SEED-Team-512-NWTL/Temp-Logger/Team_512_Dev_Board_Rev_1_BOM.csv

Id | Designator | Footprint | Quantity | Designation | Supplier and ref
1 | C1, C6, C19, C24 | C_0201_0603Metric | 4 | 2.2u
2 | C2, C20 | C_0402_1005Metric_Pad0.74x0.62mm_HandSolder | 2 | 10u
3 | C3, C10, C11, C14, C21, C28, C29, C32 | C_0201_0603Metric | 8 | 100n
4 | C4, C22 | C_0201_0603Metric | 2 | 10n
5 | C5, C23 | C_0201_0603Metric | 2 | 2.2n
6 | C8, C26 | C_0201_0603Metric | 2 | 3.9p
7 | C9, C27 | C_0201_0603Metric | 2 | 1.5p
8 | C12, C30 | C_0201_0603Metric | 2 | 2.0p
9 | C15, C33 | C_0201_0603Metric | 2 | 0.3p
10 | C17, C18, C54, C55 | C_0603_1608Metric_Pad1.08x0.95mm_HandSolder | 4 | 1u
11 | C34, C40 | C_0402_1005Metric_Pad0.74x0.62mm_HandSolder | 2 | 12p
12 | C35, C36, C49, C50 | C_0603_1608Metric_Pad1.08x0.95mm_HandSolder | 4 | 4.7u
13 | C37, C38, C39, C42, C43, C44, C45, C46, C47, C48, C56 | C_0402_1005Metric_Pad0.74x0.62mm_HandSolder | 11 | 100n
14 | C41 | C_0603_1608Metric_Pad1.08x0.95mm_HandSolder | 1 | 3.3u
15 | C51 | C_0603_1608Metric_Pad1.08x0.95mm_HandSolder | 1 | 100n
16 | C52 | C_0603_1608Metric | 1 | 10p
17 | C53 | C_0603_1608Metric | 1 | 4.7u
18 | D1, D2, D3, D4, D5, D8, D9, D10 | LED_0805_2012Metric | 8 | LTST-C171GKT
19 | D6, D7 | D_SOD-123 | 2 | BZT52C5V1
20 | J1, J4, J7 | 1053091102 | 3 | 1053091102
21 | J2 | PinHeader_1x03_P2.54mm_Vertical | 1 | 2.54mm
22 | J3 | USB_C_Receptacle_GCT_USB4105-xx-A_16P_TopMnt_Horizontal | 1 | USB_C_Receptacle_USB2.0_14P
23 | J5, J6 | Banana_Cliff_FCR7350B_S16N-PC_Horizontal | 2 | FCR7350B
24 | J8, J9 | MM8130-2600RA2 | 2 | MM8130-2600RA2
25 | J10, J11, J12 | PinHeader_1x02_P1.00mm_Vertical | 3 | 1mm
26 | L1, L5 | L_0603_1608Metric | 2 | 4.7u
27 | L2, L6 | L_0201_0603Metric | 2 | 2.7n
28 | L3, L4, L7, L8 | L_0201_0603Metric | 4 | 3.5n
29 | L9 | L_1008_2520Metric_Pad1.43x2.20mm_HandSolder | 1 | 1u
30 | Q1, Q2, Q3, Q4, Q7, Q8 | SMMBT3904LT1G | 6 | SMMBT3904LT1G
31 | Q5, Q6 | SOT-23 | 2 | AO3401A
32 | R1, R2, R3, R4, R10, R11, R12, R13, R16, R17, R18, R19, R36, R37 | R_0603_1608Metric_Pad0.98x0.95mm_HandSolder | 14 | 0
33 | R5, R14 | R_0201_0603Metric | 2 | 0
34 | R6 | R_1206_3216Metric_Pad1.30x1.75mm_HandSolder | 1 | 100m
35 | R7, R15 | R_0201_0603Metric | 2 | 1k
36 | R20 | R_0402_1005Metric_Pad0.72x0.64mm_HandSolder | 1 | 12k
37 | R21, R23, R24, R25, R26 | R_0402_1005Metric_Pad0.72x0.64mm_HandSolder | 5 | 1k
38 | R22, R27, R28, R29 | R_0402_1005Metric_Pad0.72x0.64mm_HandSolder | 4 | 100
39 | R30, R31 | R_0603_1608Metric_Pad0.98x0.95mm_HandSolder | 2 | 5.1k
40 | R32, R41, R42, R43 | R_0603_1608Metric_Pad0.98x0.95mm_HandSolder | 4 | 100
41 | R33 | R_0603_1608Metric_Pad0.98x0.95mm_HandSolder | 1 | 100k
42 | R34, R35, R38 | R_0603_1608Metric_Pad0.98x0.95mm_HandSolder | 3 | 22k
43 | R39, R40 | R_0402_1005Metric_Pad0.72x0.64mm_HandSolder | 2 | 4.7k
44 | SW1, SW2 | SW_Push_1P1T_NO_CK_KMR2 | 2 | KMR211G LFS
45 | TP1, TP2, TP3, TP4, TP5, TP6, TP7, TP9, TP10, TP11, TP12, TP13, TP14, TP15, TP16, TP18, TP19, TP20, TP21, TP22 | TestPoint_Pad_D1.0mm | 20 | 1.0mm
46 | U1, U2 | NRF54L15-QFAA-R | 2 | nRF54L15-QFAA-R
47 | U3 | WSON-6-1EP_2x2mm_P0.65mm_EP1x1.6mm | 1 | TMP117xxDRV
48 | U6 | SOT-23-6 | 1 | USBLC6-2SC6
49 | U7 | LQFP-64_10x10mm_P0.5mm | 1 | FT2232HL
50 | U8 | SOT-563 | 1 | TPS62A01ADRL
51 | Y1, Y2 | ECS-320-8-37B-CKY-TR | 2 | ECS-320-8-37B-CKY-TR
52 | Y3 | ABM8AIG-12.000MHZ-12-2Z-T3 | 1 | ABM8AIG-12.000MHZ-12-2Z-T3
53 | Y4, Y5 | SC-20S,32.768kHz,20PPM,9pF | 2 | SC-20S,32.768kHz,20PPM,9pF
