SEED-Team-512-NWTL/Temp-Logger/production/NWTL_Dev_Board_Rev_1_bom.csv

Designator | Footprint | Quantity | Value | LCSC Part # | Do Not Populate
C1, C19, C24, C6 | 0201 | 4 | 2.2u | C76933
C10, C11, C14, C21, C28, C29, C3, C32 | 0201 | 8 | 100n | C284992
C12, C30 | 0201 | 2 | 2.0p | C668326
C15, C33 | 0201 | 2 | 0.3p | C76927
C17, C18, C54, C55 | 0603 | 4 | 1u |  | TRUE
C2, C20 | 0402 | 2 | 10u | C15525
C22, C4 | 0201 | 2 | 10n | C309453
C23, C5 | 0201 | 2 | 2.2n | C526947
C26, C8 | 0201 | 2 | 3.9p | C76926
C27, C9 | 0201 | 2 | 1.5p | C435397
C34, C40 | 0402 | 2 | 12p | C85875
C35, C36, C49, C50, C53 | 0603 | 5 | 4.7u | C1705
C37, C38, C39, C42, C43, C44, C45, C46, C47, C48, C56 | 0402 | 11 | 100n | C1525
C41 | 0603 | 1 | 3.3u | C51412
C51 | 0603 | 1 | 100n | C1590
C52 | 0603 | 1 | 10p |  | TRUE
D1, D10, D2, D3, D4, D5, D8, D9 | 0805 | 8 | LTST-C171GKT | C913075
D6, D7 | D_SOD-123 | 2 | BZT52C5V1 | C2117
J1, J4, J7 | 1053091102 | 3 | 1053091102 | C2938824
J10, J11, J12 | PinHeader_1x02_P1.00mm_Vertical | 3 | 1mm |  | TRUE
J13 | PinHeader_1x09_P2.54mm_Vertical | 1 | 2.54mm |  | TRUE
J2 | PinHeader_1x03_P2.54mm_Vertical | 1 | 2.54mm |  | TRUE
J3 | USB_C_Receptacle_GCT_USB4105-xx-A_16P_TopMnt_Horizontal | 1 | USB_C_Receptacle_USB2.0_14P | C3020560
J5, J6 | Banana_Cliff_FCR7350B_S16N-PC_Horizontal | 2 | FCR7350B |  | TRUE
J8, J9 | MM8130-2600RA2 | 2 | MM8130-2600RA2 | C167503
L1, L5 | 0603 | 2 | 4.7u | C76799
L2, L6 | 0201 | 2 | 2.7n | C7216765
L3, L4, L7, L8 | 0201 | 4 | 3.5n | C3911055
L9 | 1008 | 1 | 1u | C435392
Q1, Q2, Q3, Q4, Q7, Q8 | SMMBT3904LT1G | 6 | SMMBT3904LT1G | C84555
Q5, Q6 | SOT-23 | 2 | AO3401A | C15127
R1, R10, R11, R12, R13, R16, R17, R18, R19, R2, R3, R36, R37, R4 | 0603 | 14 | 0 | C177335
R14, R5 | 0201 | 2 | 0 | C100147
R15, R7 | 0201 | 2 | 1k | C131396
R20 | 0402 | 1 | 12k | C114760
R21, R23, R24, R25, R26 | 0402 | 5 | 1k | C71623
R22, R27, R28, R29, R42, R43 | 0402 | 6 | 100 | C82865
R30, R31 | 0603 | 2 | 5.1k | C14677
R32, R41 | 0603 | 2 | 100 | C105588
R33 | 0603 | 1 | 100k | C14675
R34, R35, R38 | 0603 | 3 | 22k | C114065
R39, R40, R44, R45 | 0402 | 4 | 4.7k | C105870
R6 | 1206 | 1 | 330m | C2932844
SW1, SW2 | SW_Push_1P1T_NO_CK_KMR2 | 2 | KMR211G LFS | C221675
U1, U2 | NRF54L15-QFAA-R | 2 | nRF54L15-QFAA-R | C42458750
U3 | WSON-6-1EP_2x2mm_P0.65mm_EP1x1.6mm | 1 | TMP117AIDRVR | C699536
U6 | SOT-23-6 | 1 | USBLC6-2SC6 | C7519
U7 | LQFP-64_10x10mm_P0.5mm | 1 | FT2232HL | C27882
U8 | SOT-563 | 1 | TPS62A01ADRL | C5181455
Y1, Y2 | ECS-320-8-37B-CKY-TR | 2 | ECS-320-8-37B-CKY-TR | C2636238
Y3 | ABM8AIG-12.000MHZ-12-2Z-T3 | 1 | ABM8AIG-12.000MHZ-12-2Z-T3 | C1985448
Y4, Y5 | SC-20S,32.768kHz,20PPM,9pF | 2 | SC-20S,32.768kHz,20PPM,9pF | C97603
