SEED-Team-512-NWTL/Temp-Logger/Temp-Logger.kicad_pcb

## KiCad design Temp-Logger.kicad_pcb (2026-11-11)

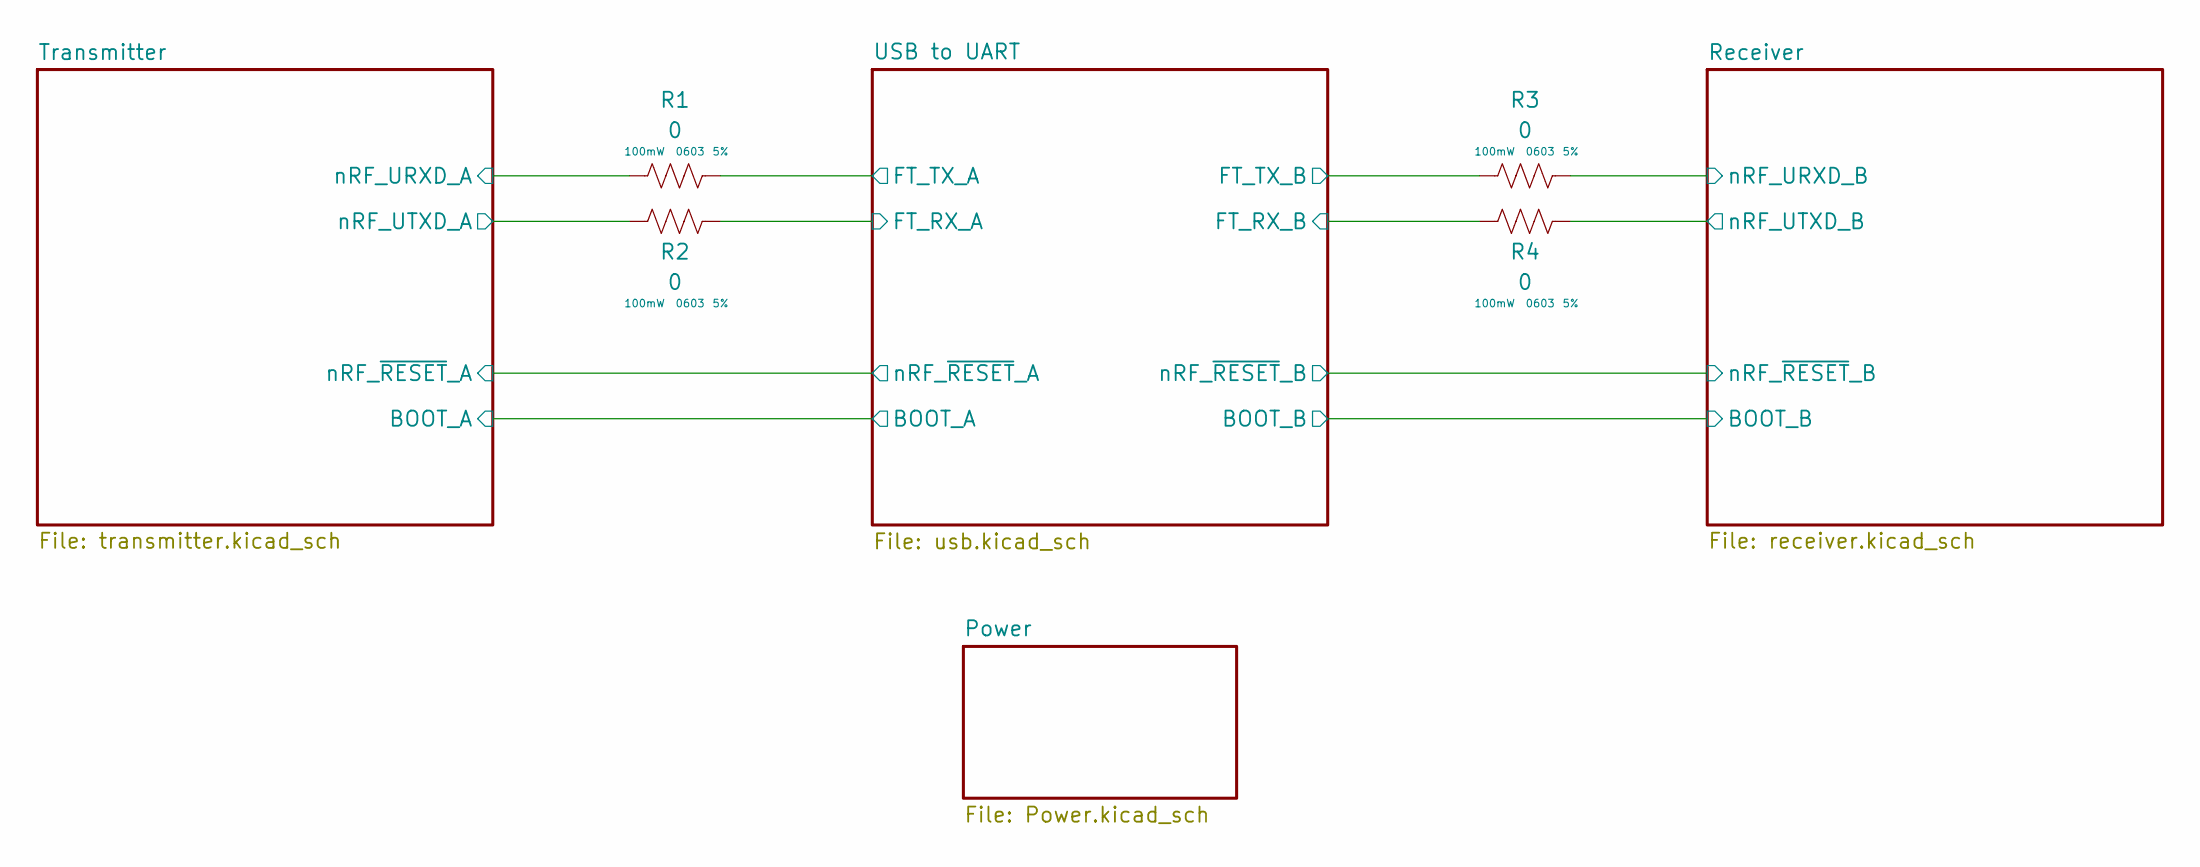
[picture p1: schematic Temp-Logger.kicad_sch, Temperature Logger]

Parts:
R1, R2, R3, R4: 0; R_0603_1608Metric_Pad0.98x0.95mm_HandSolder; Tolerance 5%; LCSC C177335

Connections:
/Receiver/nRF_URXD_B: R3.2; also elsewhere on the board
/Receiver/nRF_UTXD_B: R4.2; also elsewhere on the board
/Transmitter/nRF_URXD_A: R1.1; also elsewhere on the board
/Transmitter/nRF_UTXD_A: R2.1; also elsewhere on the board
/USB to UART/FT_RX_A: R2.2; also elsewhere on the board
/USB to UART/FT_RX_B: R4.1; also elsewhere on the board
/USB to UART/FT_TX_A: R1.2; also elsewhere on the board
/USB to UART/FT_TX_B: R3.1; also elsewhere on the board

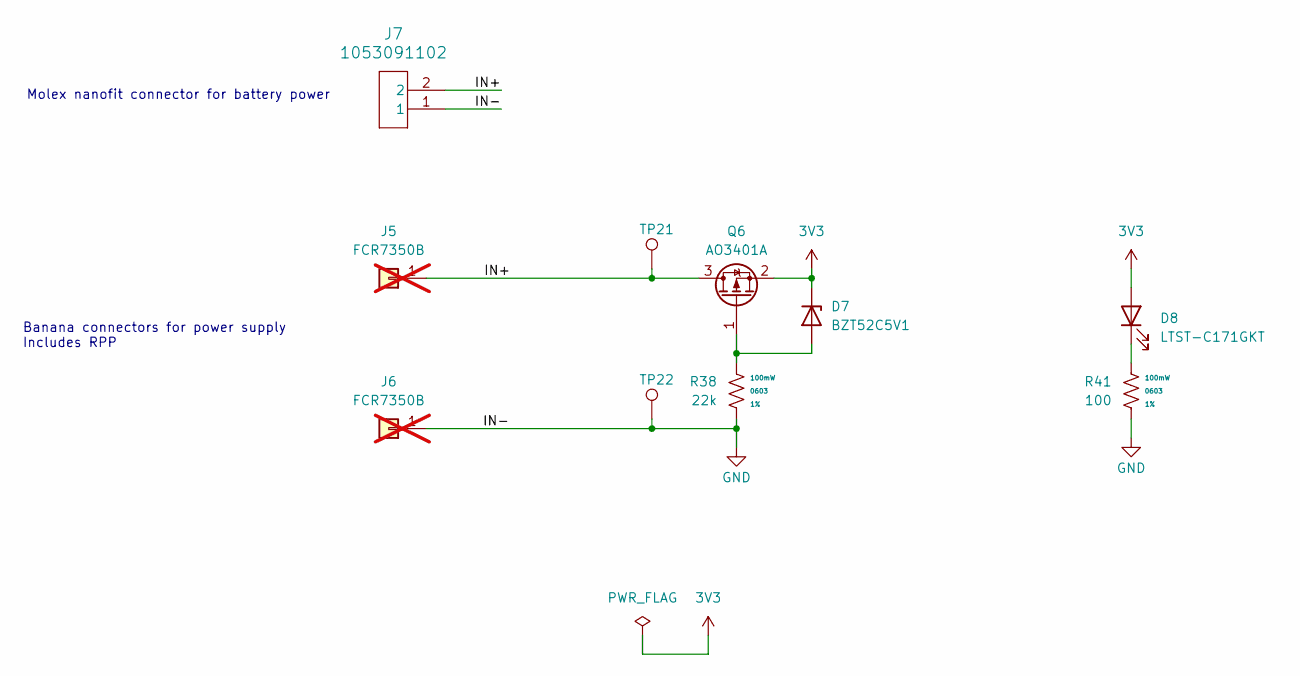
[picture p2: schematic Power.kicad_sch, Temperature Logger]

Parts:
D7: BZT52C5V1; D_SOD-123; LCSC C2117
D8: LTST-C171GKT; LED_0805_2012Metric; LCSC C913075
J5, J6: FCR7350B; Banana_Cliff_FCR7350B_S16N-PC_Horizontal; not fitted
J7: 1053091102; LCSC C2938824
Q6: AO3401A; SOT-23; LCSC C15127
R38: 22k; R_0603_1608Metric_Pad0.98x0.95mm_HandSolder; Tolerance 1%; LCSC C114065
R41: 100; R_0603_1608Metric_Pad0.98x0.95mm_HandSolder; Tolerance 1%; LCSC C105588
TP21, TP22: 1.0mm; TestPoint_Pad_D1.0mm

Connections:
3V3: D7.1 (K), D8.2 (A), Q6.2 (S); also elsewhere on the board
/Power/IN+: J5.1 (Pin_1_1), J7.2, Q6.3 (D), TP21.1 (1_1)
GND: J6.1 (Pin_1_1), J7.1, R38.1, R41.1, TP22.1 (1_1); also elsewhere on the board
unnamed: D7.2 (A), Q6.1 (G), R38.2
unnamed: D8.1 (K), R41.2

Notes on the sheet:
Banana connectors for power supply Includes RPP
Molex nanofit connector for battery power

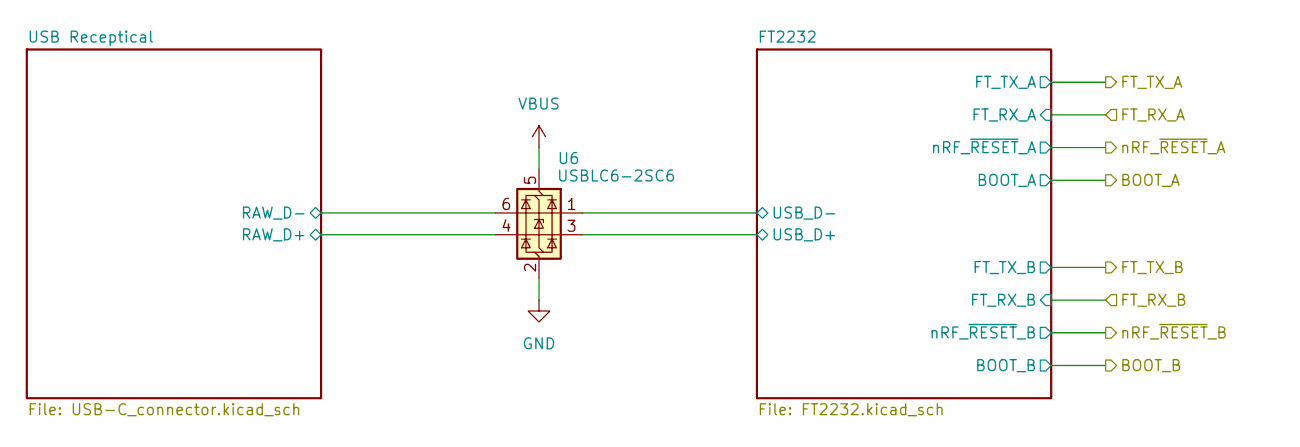
[picture p3: schematic usb.kicad_sch, Temperature Logger]

Parts:
U6: USBLC6-2SC6; SOT-23-6; LCSC C7519

Connections:
/USB to UART/FT2232/USB_D+: U6.3 (I/O2); also elsewhere on the board
/USB to UART/FT2232/USB_D-: U6.1 (I/O1); also elsewhere on the board
/USB to UART/USB Receptical/RAW_D+: U6.4 (I/O2); also elsewhere on the board
/USB to UART/USB Receptical/RAW_D-: U6.6 (I/O1); also elsewhere on the board
GND: U6.2 (GND); also elsewhere on the board
VBUS: U6.5 (VBUS); also elsewhere on the board

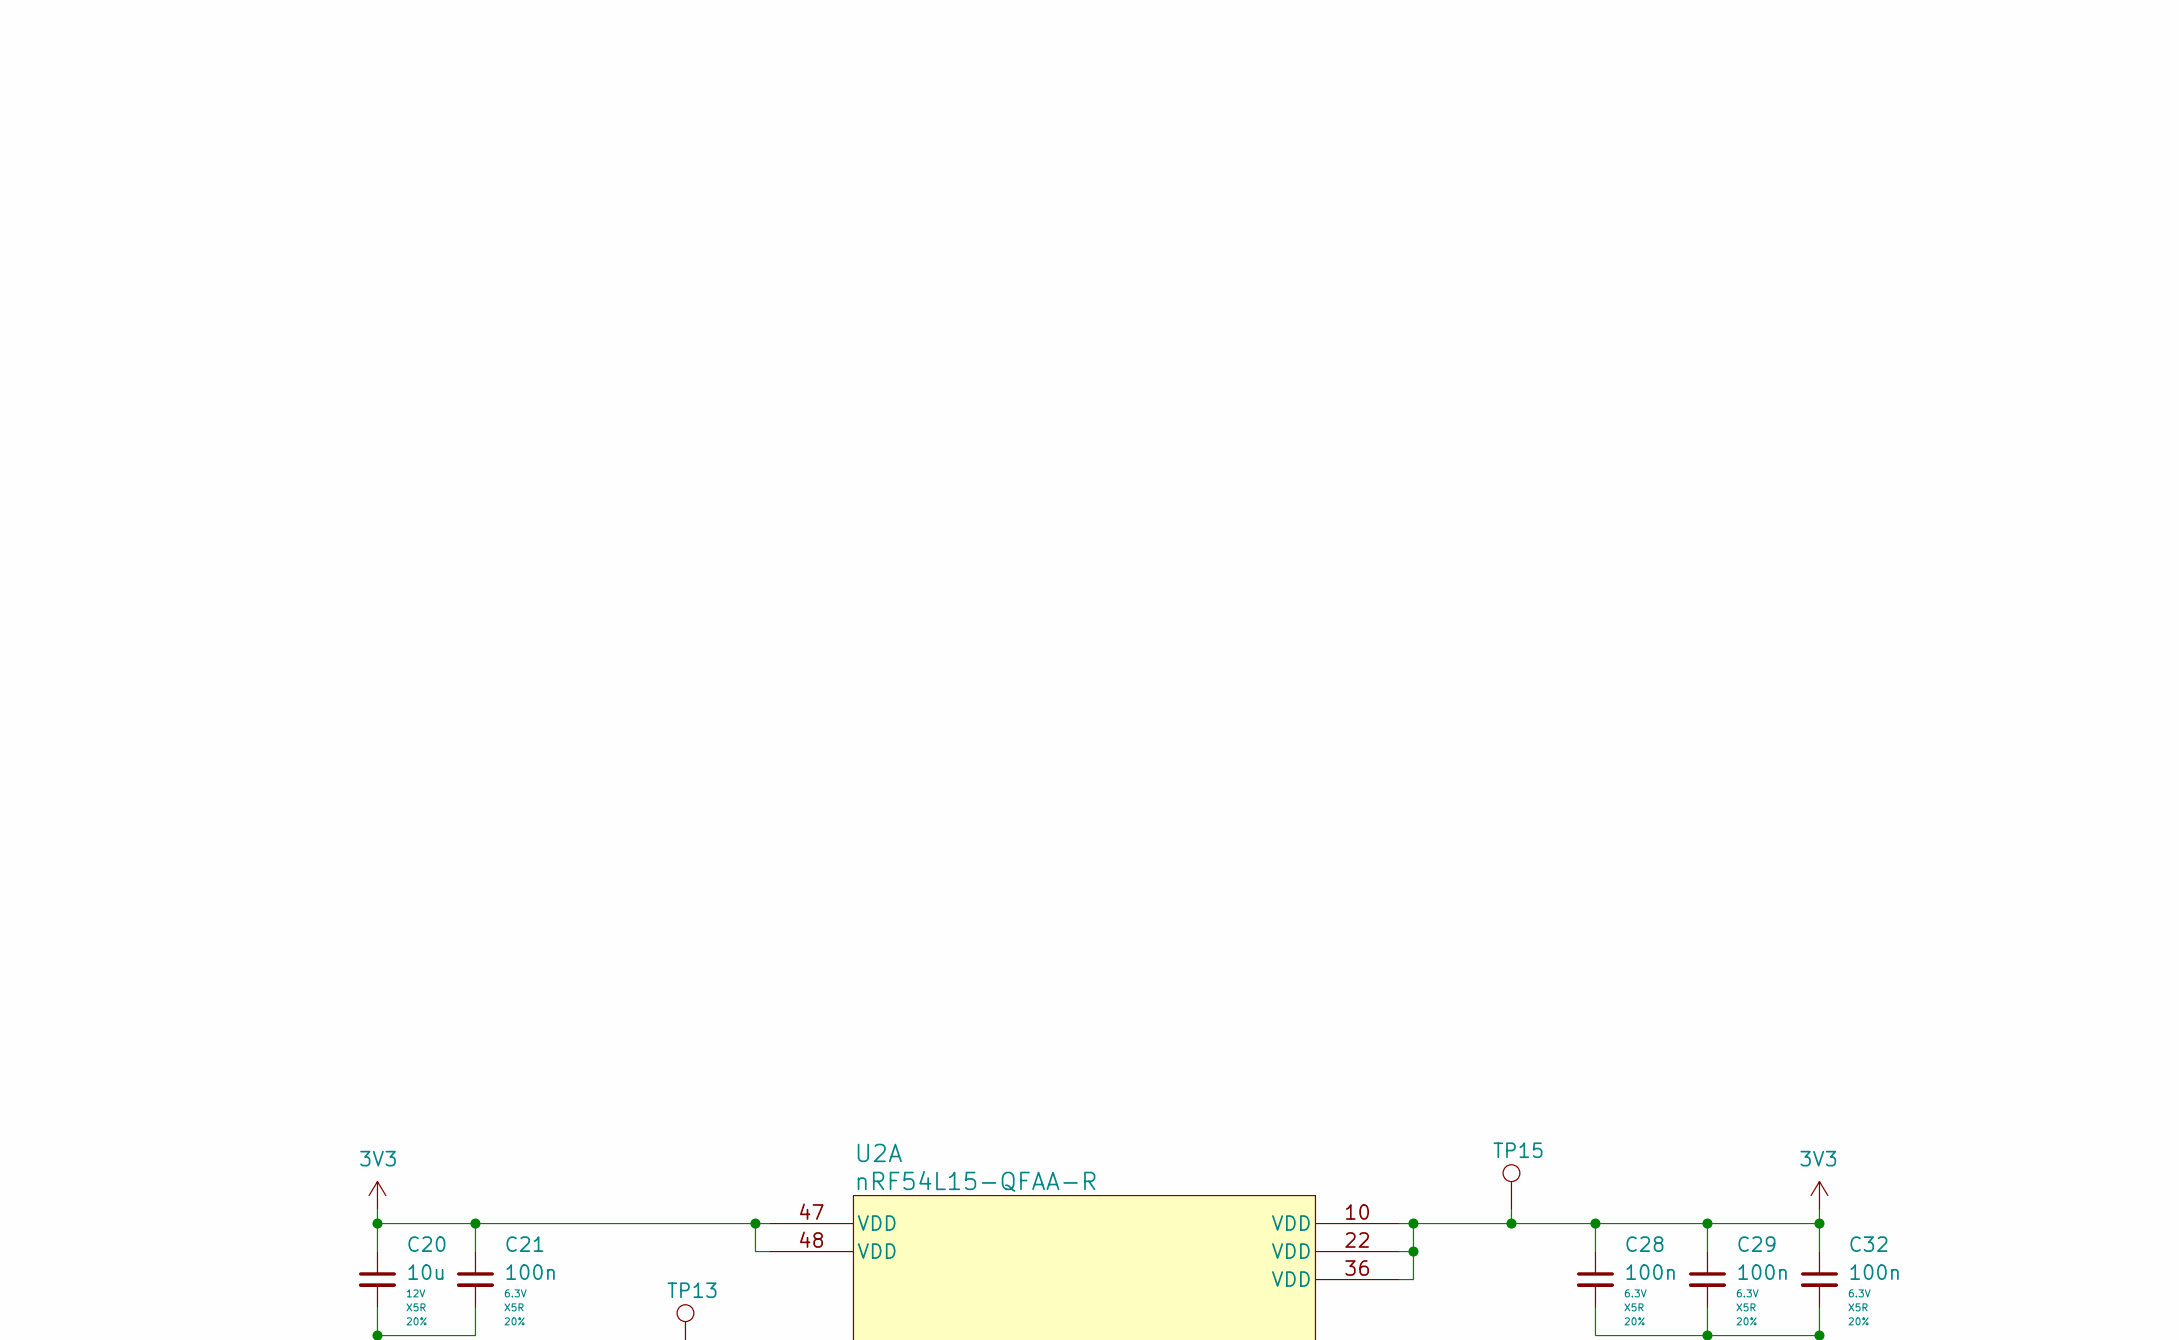
[picture p4: schematic rx_microcontroller.kicad_sch, Temperature Logger, part in row 1, column 1]

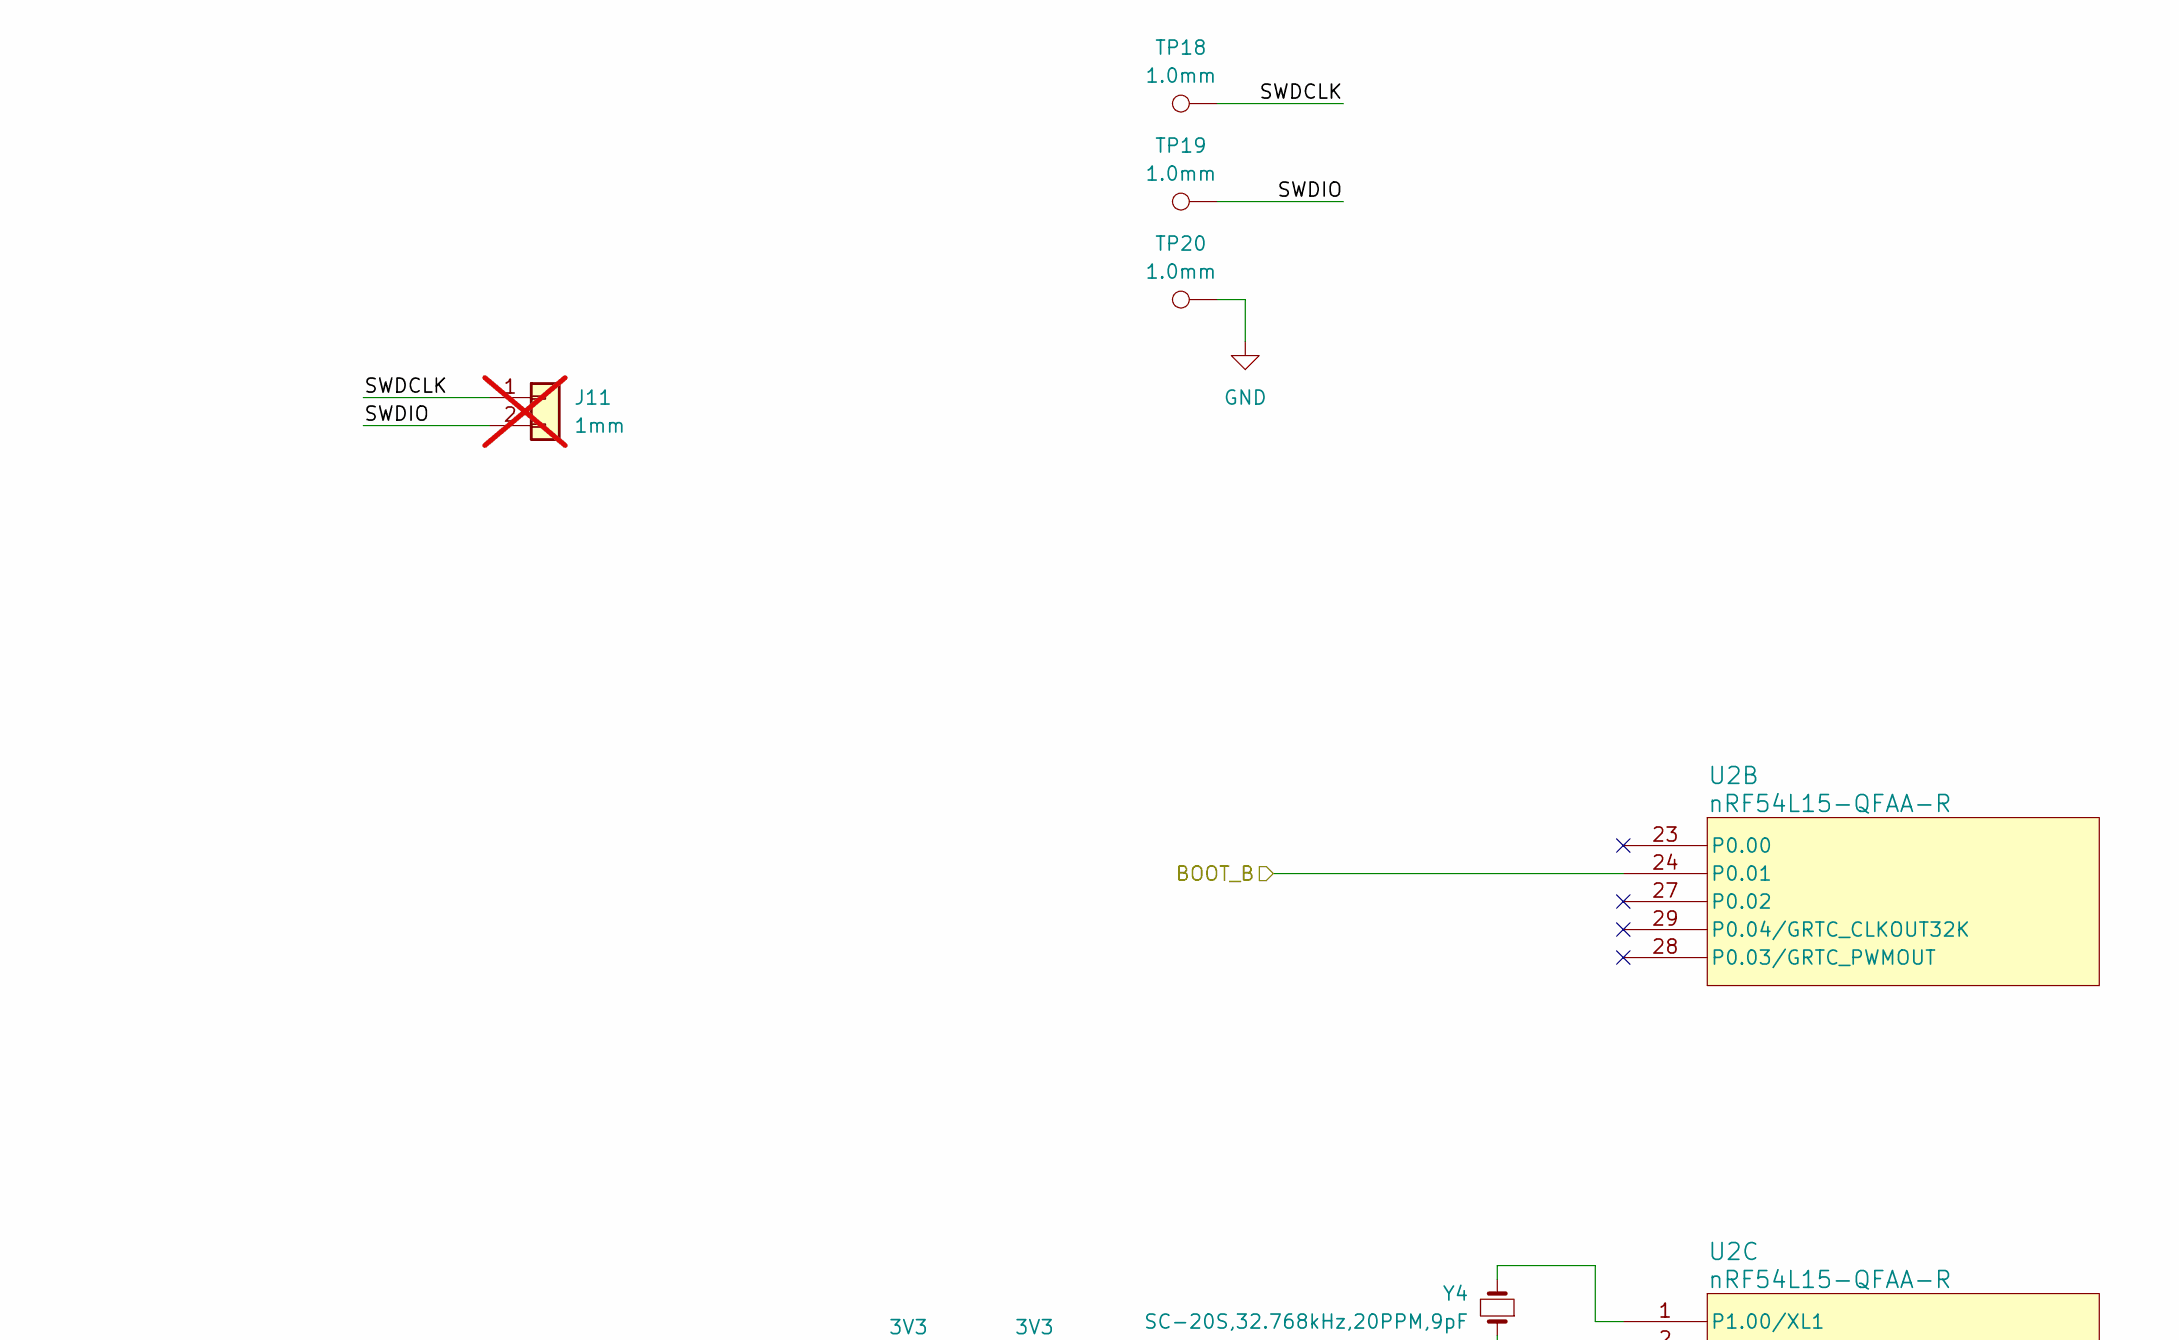
[picture p5: schematic rx_microcontroller.kicad_sch, Temperature Logger, part in row 1, column 2]

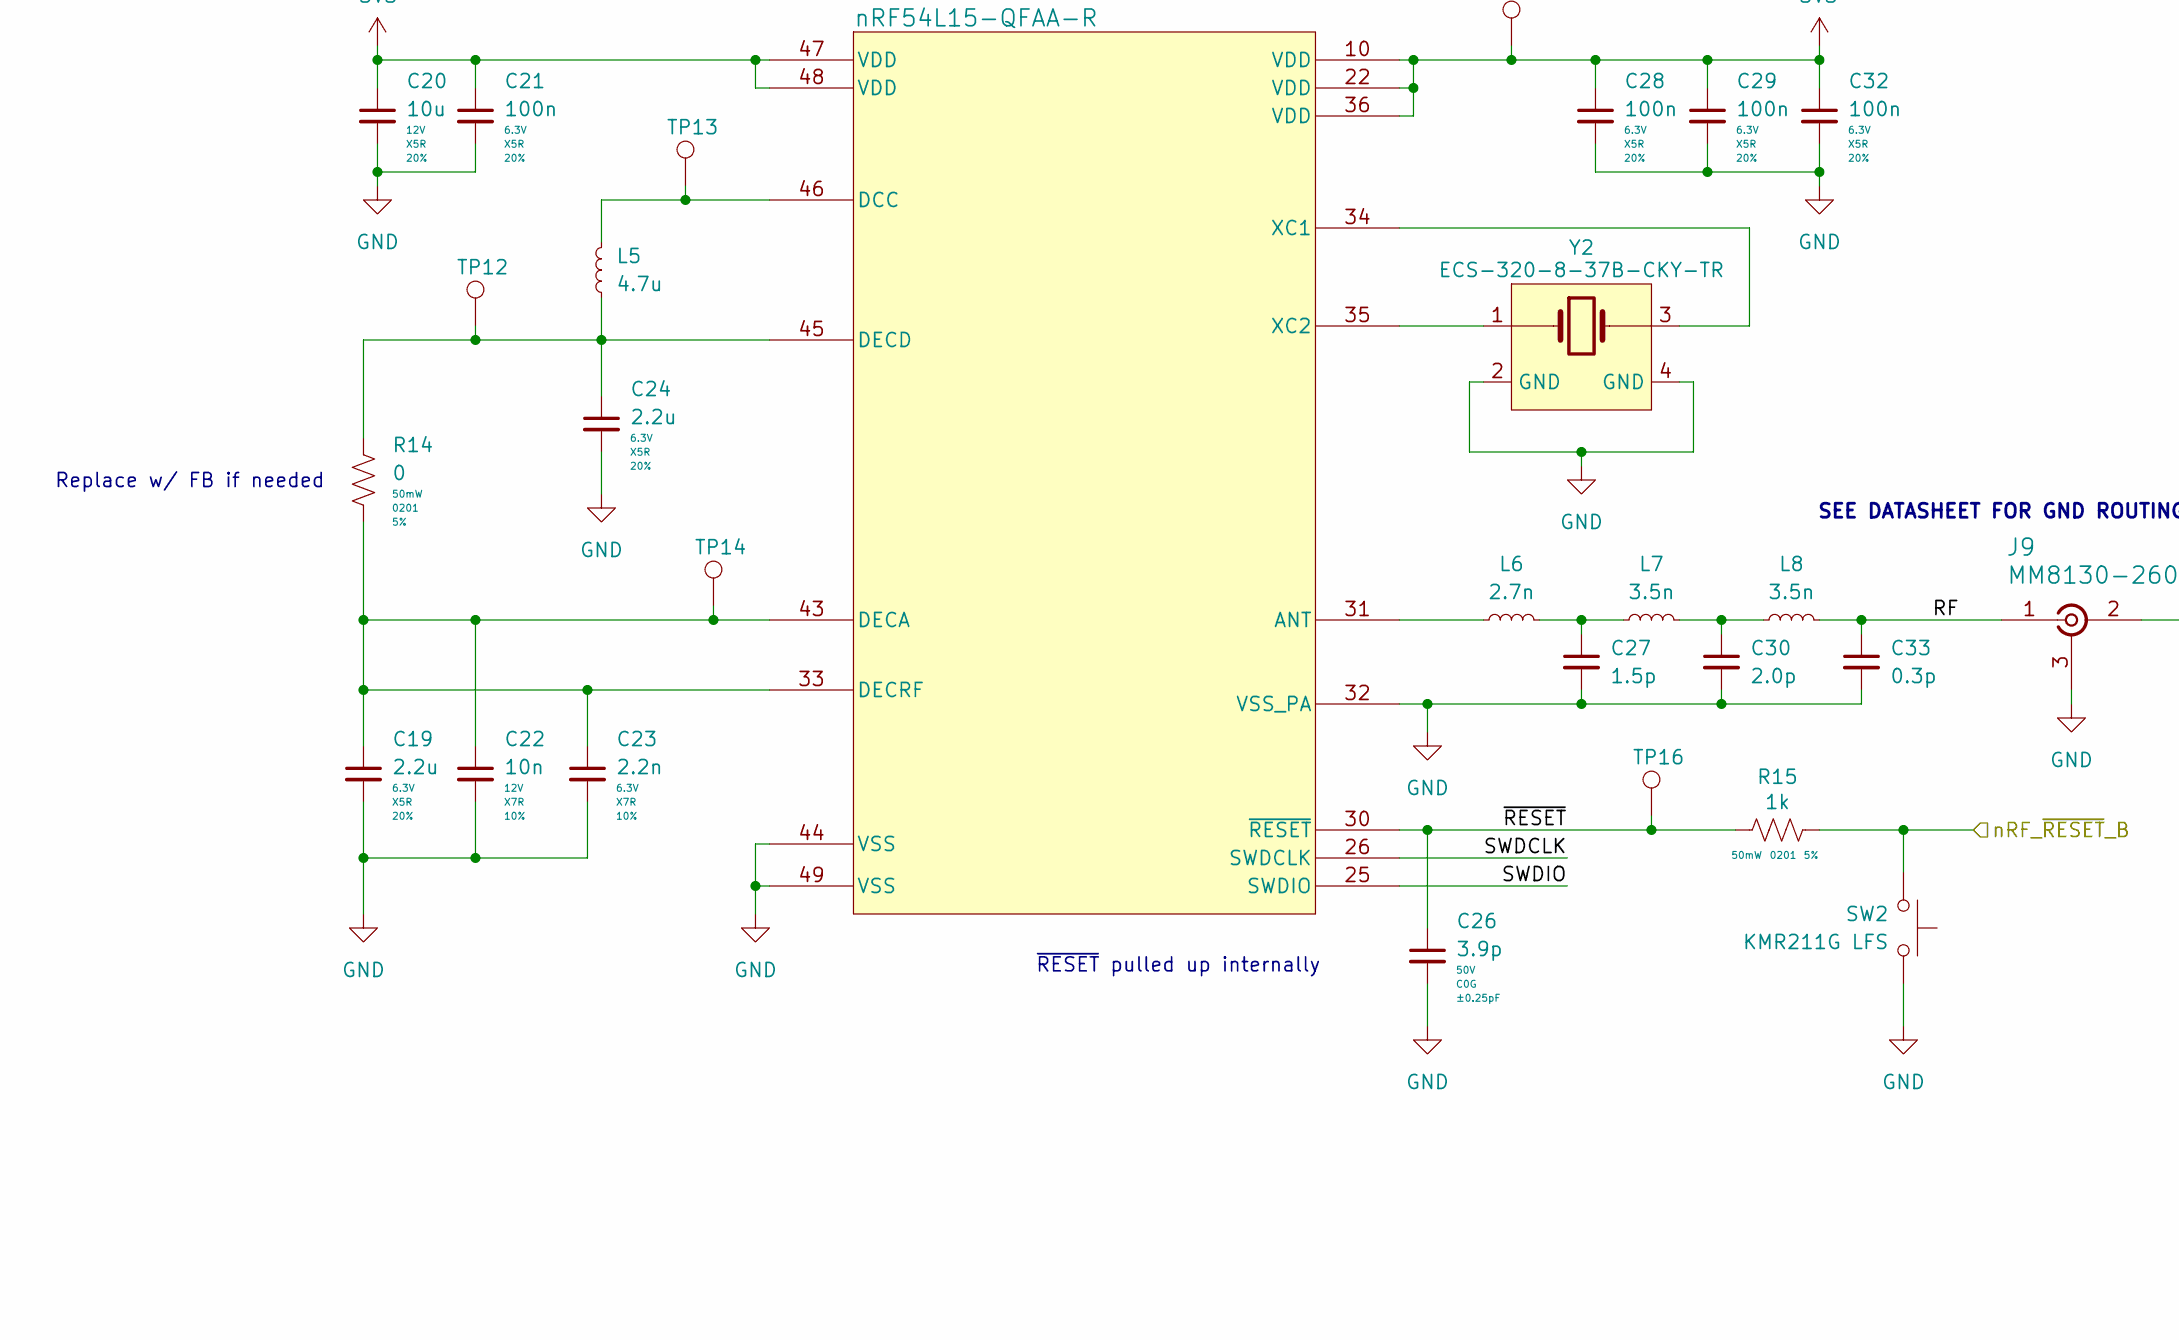
[picture p6: schematic rx_microcontroller.kicad_sch, Temperature Logger, part in row 2, column 1]

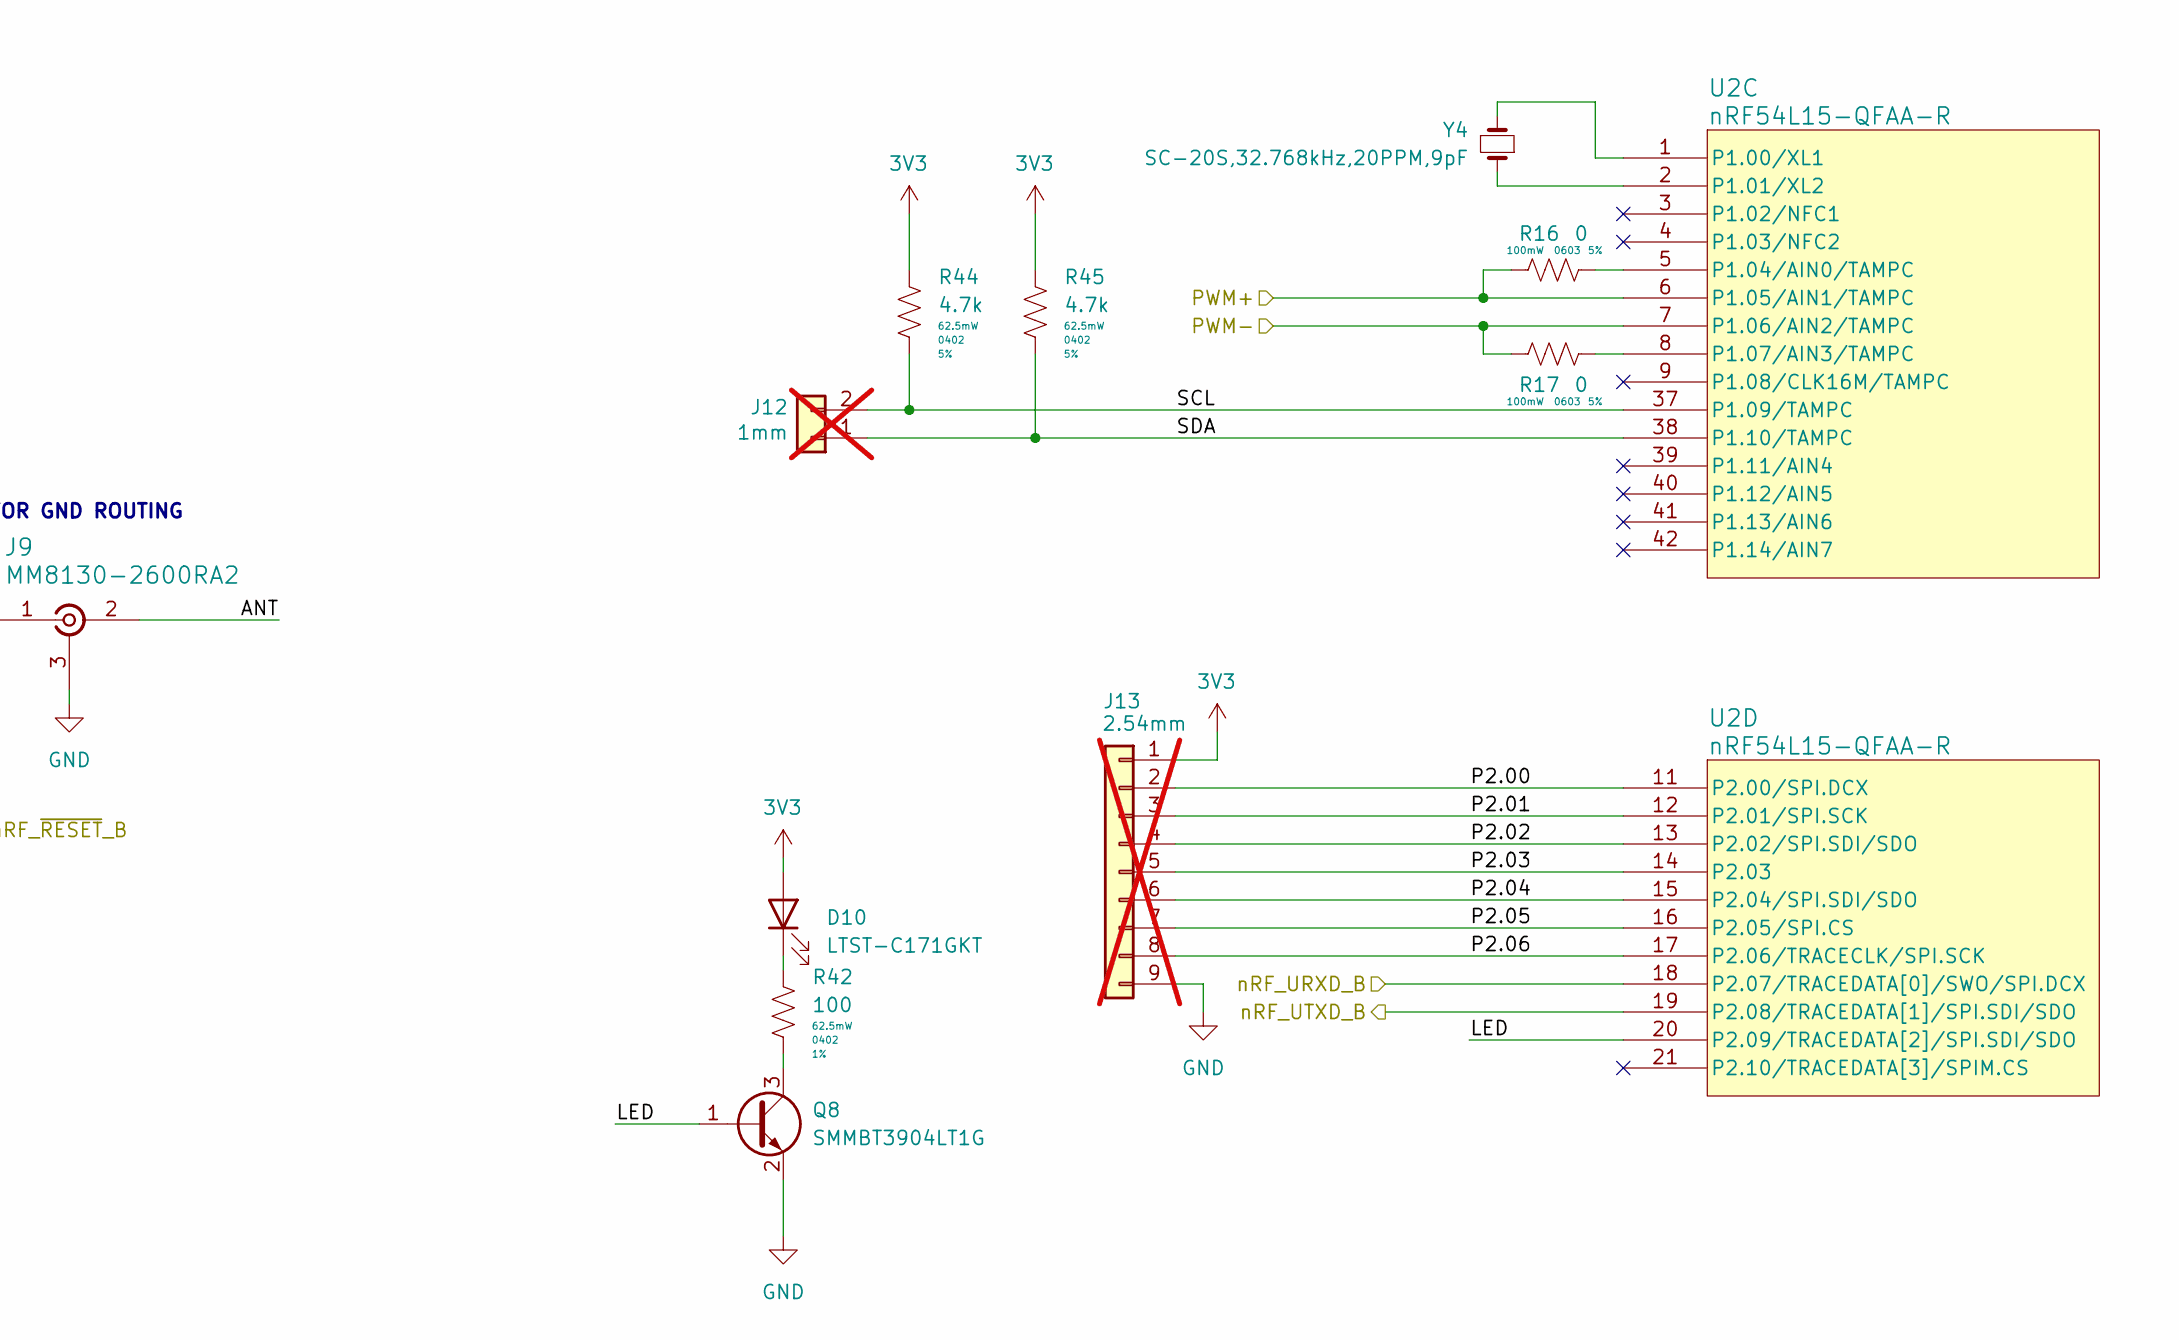
[picture p7: schematic rx_microcontroller.kicad_sch, Temperature Logger, part in row 2, column 2]

Parts:
C19, C24: 2.2u; C_0201_0603Metric; Voltage Rating 6.3V; Tolerance 20%; LCSC C76933
C20: 10u; C_0402_1005Metric_Pad0.74x0.62mm_HandSolder; Voltage Rating 12V; Tolerance 20%; LCSC C15525
C21, C28, C29, C32: 100n; C_0201_0603Metric; Voltage Rating 6.3V; Tolerance 20%; LCSC C284992
C22: 10n; C_0201_0603Metric; Voltage Rating 12V; Tolerance 10%; LCSC C309453
C23: 2.2n; C_0201_0603Metric; Voltage Rating 6.3V; Tolerance 10%; LCSC C526947
C26: 3.9p; C_0201_0603Metric; Voltage Rating 50V; Tolerance ±0.25pF; LCSC C76926
C27: 1.5p; C_0201_0603Metric; Part Number GJM0335C1E1R5WB01; LCSC C435397
C30: 2.0p; C_0201_0603Metric; Part Number GJM0335C1E2R0WB01; LCSC C668326
C33: 0.3p; C_0201_0603Metric; LCSC C76927
D10: LTST-C171GKT; LED_0805_2012Metric; LCSC C913075
J9: MM8130-2600RA2; LCSC C167503
J11, J12: 1mm; PinHeader_1x02_P1.00mm_Vertical; not fitted
J13: 2.54mm; PinHeader_1x09_P2.54mm_Vertical; not fitted
L5: 4.7u; L_0603_1608Metric; LCSC C76799
L6: 2.7n; L_0201_0603Metric; Part Number GJM0335C1E1R5WB01; LCSC C7216765
L7, L8: 3.5n; L_0201_0603Metric; Part Number LQP03HQ3N5B02; LCSC C3911055
Q8: SMMBT3904LT1G; LCSC C84555
R14: 0; R_0201_0603Metric; Tolerance 5%; LCSC C100147
R15: 1k; R_0201_0603Metric; Tolerance 5%; LCSC C131396
R16, R17: 0; R_0603_1608Metric_Pad0.98x0.95mm_HandSolder; Tolerance 5%; LCSC C177335
R42: 100; R_0402_1005Metric_Pad0.72x0.64mm_HandSolder; Tolerance 1%; LCSC C82865
R44, R45: 4.7k; R_0402_1005Metric_Pad0.72x0.64mm_HandSolder; Tolerance 5%; LCSC C105870
SW2: KMR211G LFS; SW_Push_1P1T_NO_CK_KMR2; LCSC C221675
TP12, TP13, TP14, TP15, TP16, TP18, TP19, TP20: 1.0mm; TestPoint_Pad_D1.0mm
U2: nRF54L15-QFAA-R; NRF54L15-QFAA-R
Y2: ECS-320-8-37B-CKY-TR; LCSC C2636238
Y4: SC-20S,32.768kHz,20PPM,9pF; LCSC C97603

Connections:
3V3: C20.1, C21.1, C28.1, C29.1, C32.1, D10.2 (A), J13.1, R44.1, R45.1, TP15.1 (1_1), U2.10 (VDD), U2.22 (VDD), U2.36 (VDD), U2.47 (VDD), U2.48 (VDD); also elsewhere on the board
/Receiver/BOOT_B: U2.24 (P0.01); also elsewhere on the board
/Receiver/Piezoelectric/PWM+: R16.1, U2.6 (P1.05/AIN1/TAMPC); also elsewhere on the board
/Receiver/Piezoelectric/PWM-: R17.1, U2.7 (P1.06/AIN2/TAMPC); also elsewhere on the board
/Receiver/RX Microcontroller/ANT: J9.2 (OUT)
/Receiver/RX Microcontroller/LED: Q8.1 (B), U2.20 (P2.09/TRACEDATA[2]/SPI.SDI/SDO)
/Receiver/RX Microcontroller/P2.00: J13.2, U2.11 (P2.00/SPI.DCX)
/Receiver/RX Microcontroller/P2.01: J13.3, U2.12 (P2.01/SPI.SCK)
/Receiver/RX Microcontroller/P2.02: J13.4, U2.13 (P2.02/SPI.SDI/SDO)
/Receiver/RX Microcontroller/P2.03: J13.5, U2.14 (P2.03)
/Receiver/RX Microcontroller/P2.04: J13.6, U2.15 (P2.04/SPI.SDI/SDO)
/Receiver/RX Microcontroller/P2.05: J13.7, U2.16 (P2.05/SPI.CS)
/Receiver/RX Microcontroller/P2.06: J13.8, U2.17 (P2.06/TRACECLK/SPI.SCK)
/Receiver/RX Microcontroller/RF: C33.1, J9.1 (IN), L8.2
/Receiver/RX Microcontroller/SCL: J12.2, R44.2, U2.37 (P1.09/TAMPC)
/Receiver/RX Microcontroller/SDA: J12.1, R45.2, U2.38 (P1.10/TAMPC)
/Receiver/RX Microcontroller/SWDCLK: J11.1, TP18.1 (1_1), U2.26 (SWDCLK)
/Receiver/RX Microcontroller/SWDIO: J11.2, TP19.1 (1_1), U2.25 (SWDIO)
/Receiver/RX Microcontroller/~RESET: C26.1, R15.1, TP16.1 (1_1), U2.30 (~RESET)
/Receiver/nRF_URXD_B: U2.18 (P2.07/TRACEDATA[0]/SWO/SPI.DCX); also elsewhere on the board
/Receiver/nRF_UTXD_B: U2.19 (P2.08/TRACEDATA[1]/SPI.SDI/SDO); also elsewhere on the board
/Receiver/nRF_~RESET_B: R15.2, SW2.2; also elsewhere on the board
GND: C19.2, C20.2, C21.2, C22.2, C23.2, C24.2, C26.2, C27.2, C28.2, C29.2, C30.2, C32.2, C33.2, J9.3 (GND), J9.4 (GND), J9.5 (GND), J9.6 (GND), J13.9, Q8.2 (E), SW2.1, TP20.1 (1_1), U2.32 (VSS_PA), U2.44 (VSS), U2.49 (VSS), Y2.2 (GND), Y2.4 (GND); also elsewhere on the board
unnamed: C27.1, L6.2, L7.1
unnamed: C30.1, L7.2, L8.1
unnamed: D10.1 (K), R42.1
unnamed: Q8.3 (C), R42.2
unnamed: L6.1, U2.31 (ANT)
unnamed: L5.2, TP13.1 (1_1), U2.46 (DCC)
unnamed: C19.1, C22.1, C23.1, R14.1, TP14.1 (1_1), U2.33 (DECRF), U2.43 (DECA)
unnamed: C24.1, L5.1, R14.2, TP12.1 (1_1), U2.45 (DECD)
unnamed: U2.34 (XC1), Y2.3
unnamed: U2.35 (XC2), Y2.1
unnamed: U2.1 (P1.00/XL1), Y4.2
unnamed: U2.2 (P1.01/XL2), Y4.1
unnamed: R16.2, U2.5 (P1.04/AIN0/TAMPC)
unnamed: R17.2, U2.8 (P1.07/AIN3/TAMPC)

Notes on the sheet:
~{RESET} pulled up internally
Replace w/ FB if needed
SEE DATASHEET FOR GND ROUTING

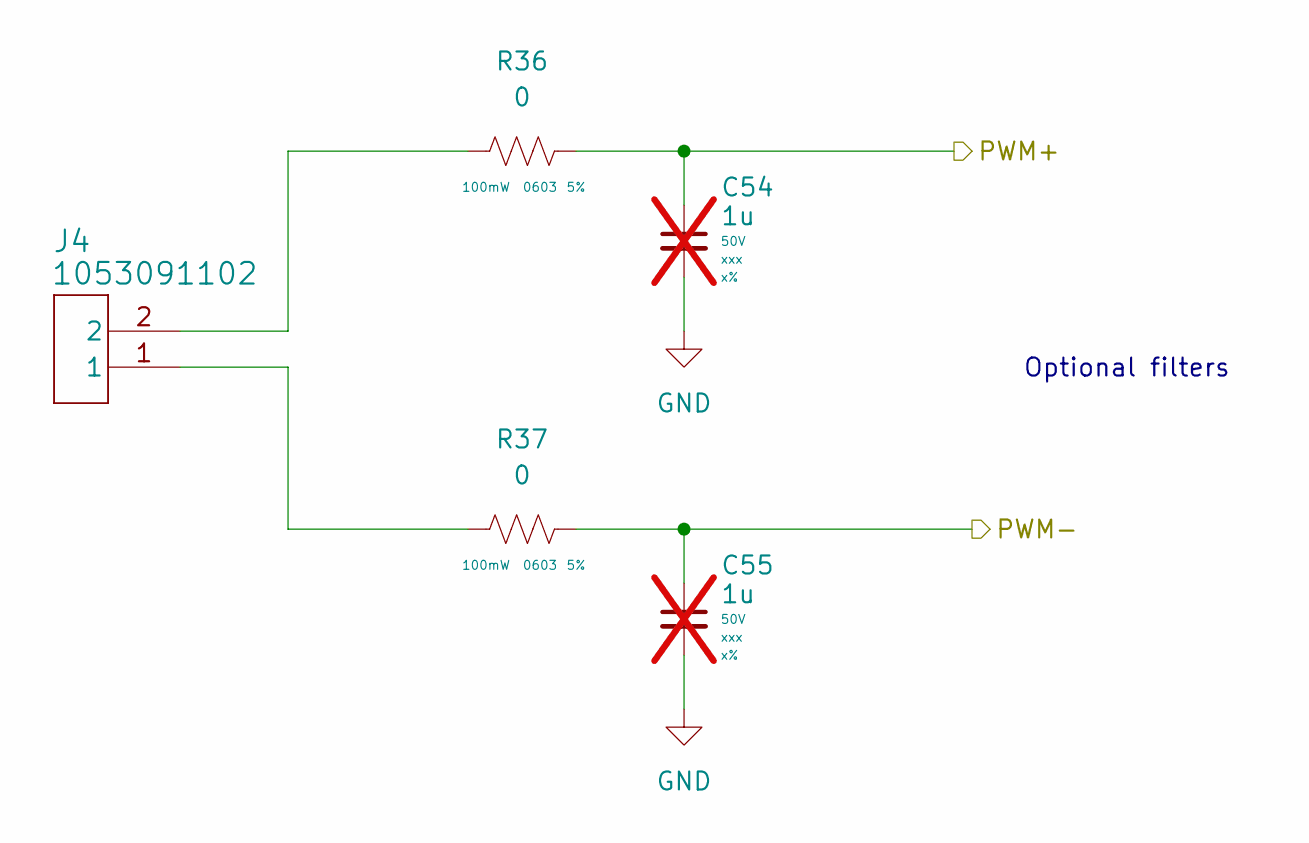
[picture p8: schematic piezo_RX.kicad_sch, Temperature Logger]

Parts:
C54, C55: 1u; C_0603_1608Metric_Pad1.08x0.95mm_HandSolder; Voltage Rating 50V; Tolerance x%; not fitted
J4: 1053091102; LCSC C2938824
R36, R37: 0; R_0603_1608Metric_Pad0.98x0.95mm_HandSolder; Tolerance 5%; LCSC C177335

Connections:
/Receiver/Piezoelectric/PWM+: C54.1, R36.2; also elsewhere on the board
/Receiver/Piezoelectric/PWM-: C55.1, R37.2; also elsewhere on the board
GND: C54.2, C55.2; also elsewhere on the board
unnamed: J4.1, R37.1
unnamed: J4.2, R36.1

Notes on the sheet:
Optional filters
