SEED-Team-512-NWTL/Temp-Logger/Temp-Logger.kicad_pcb

## KiCad design Temp-Logger.kicad_pcb (continued)

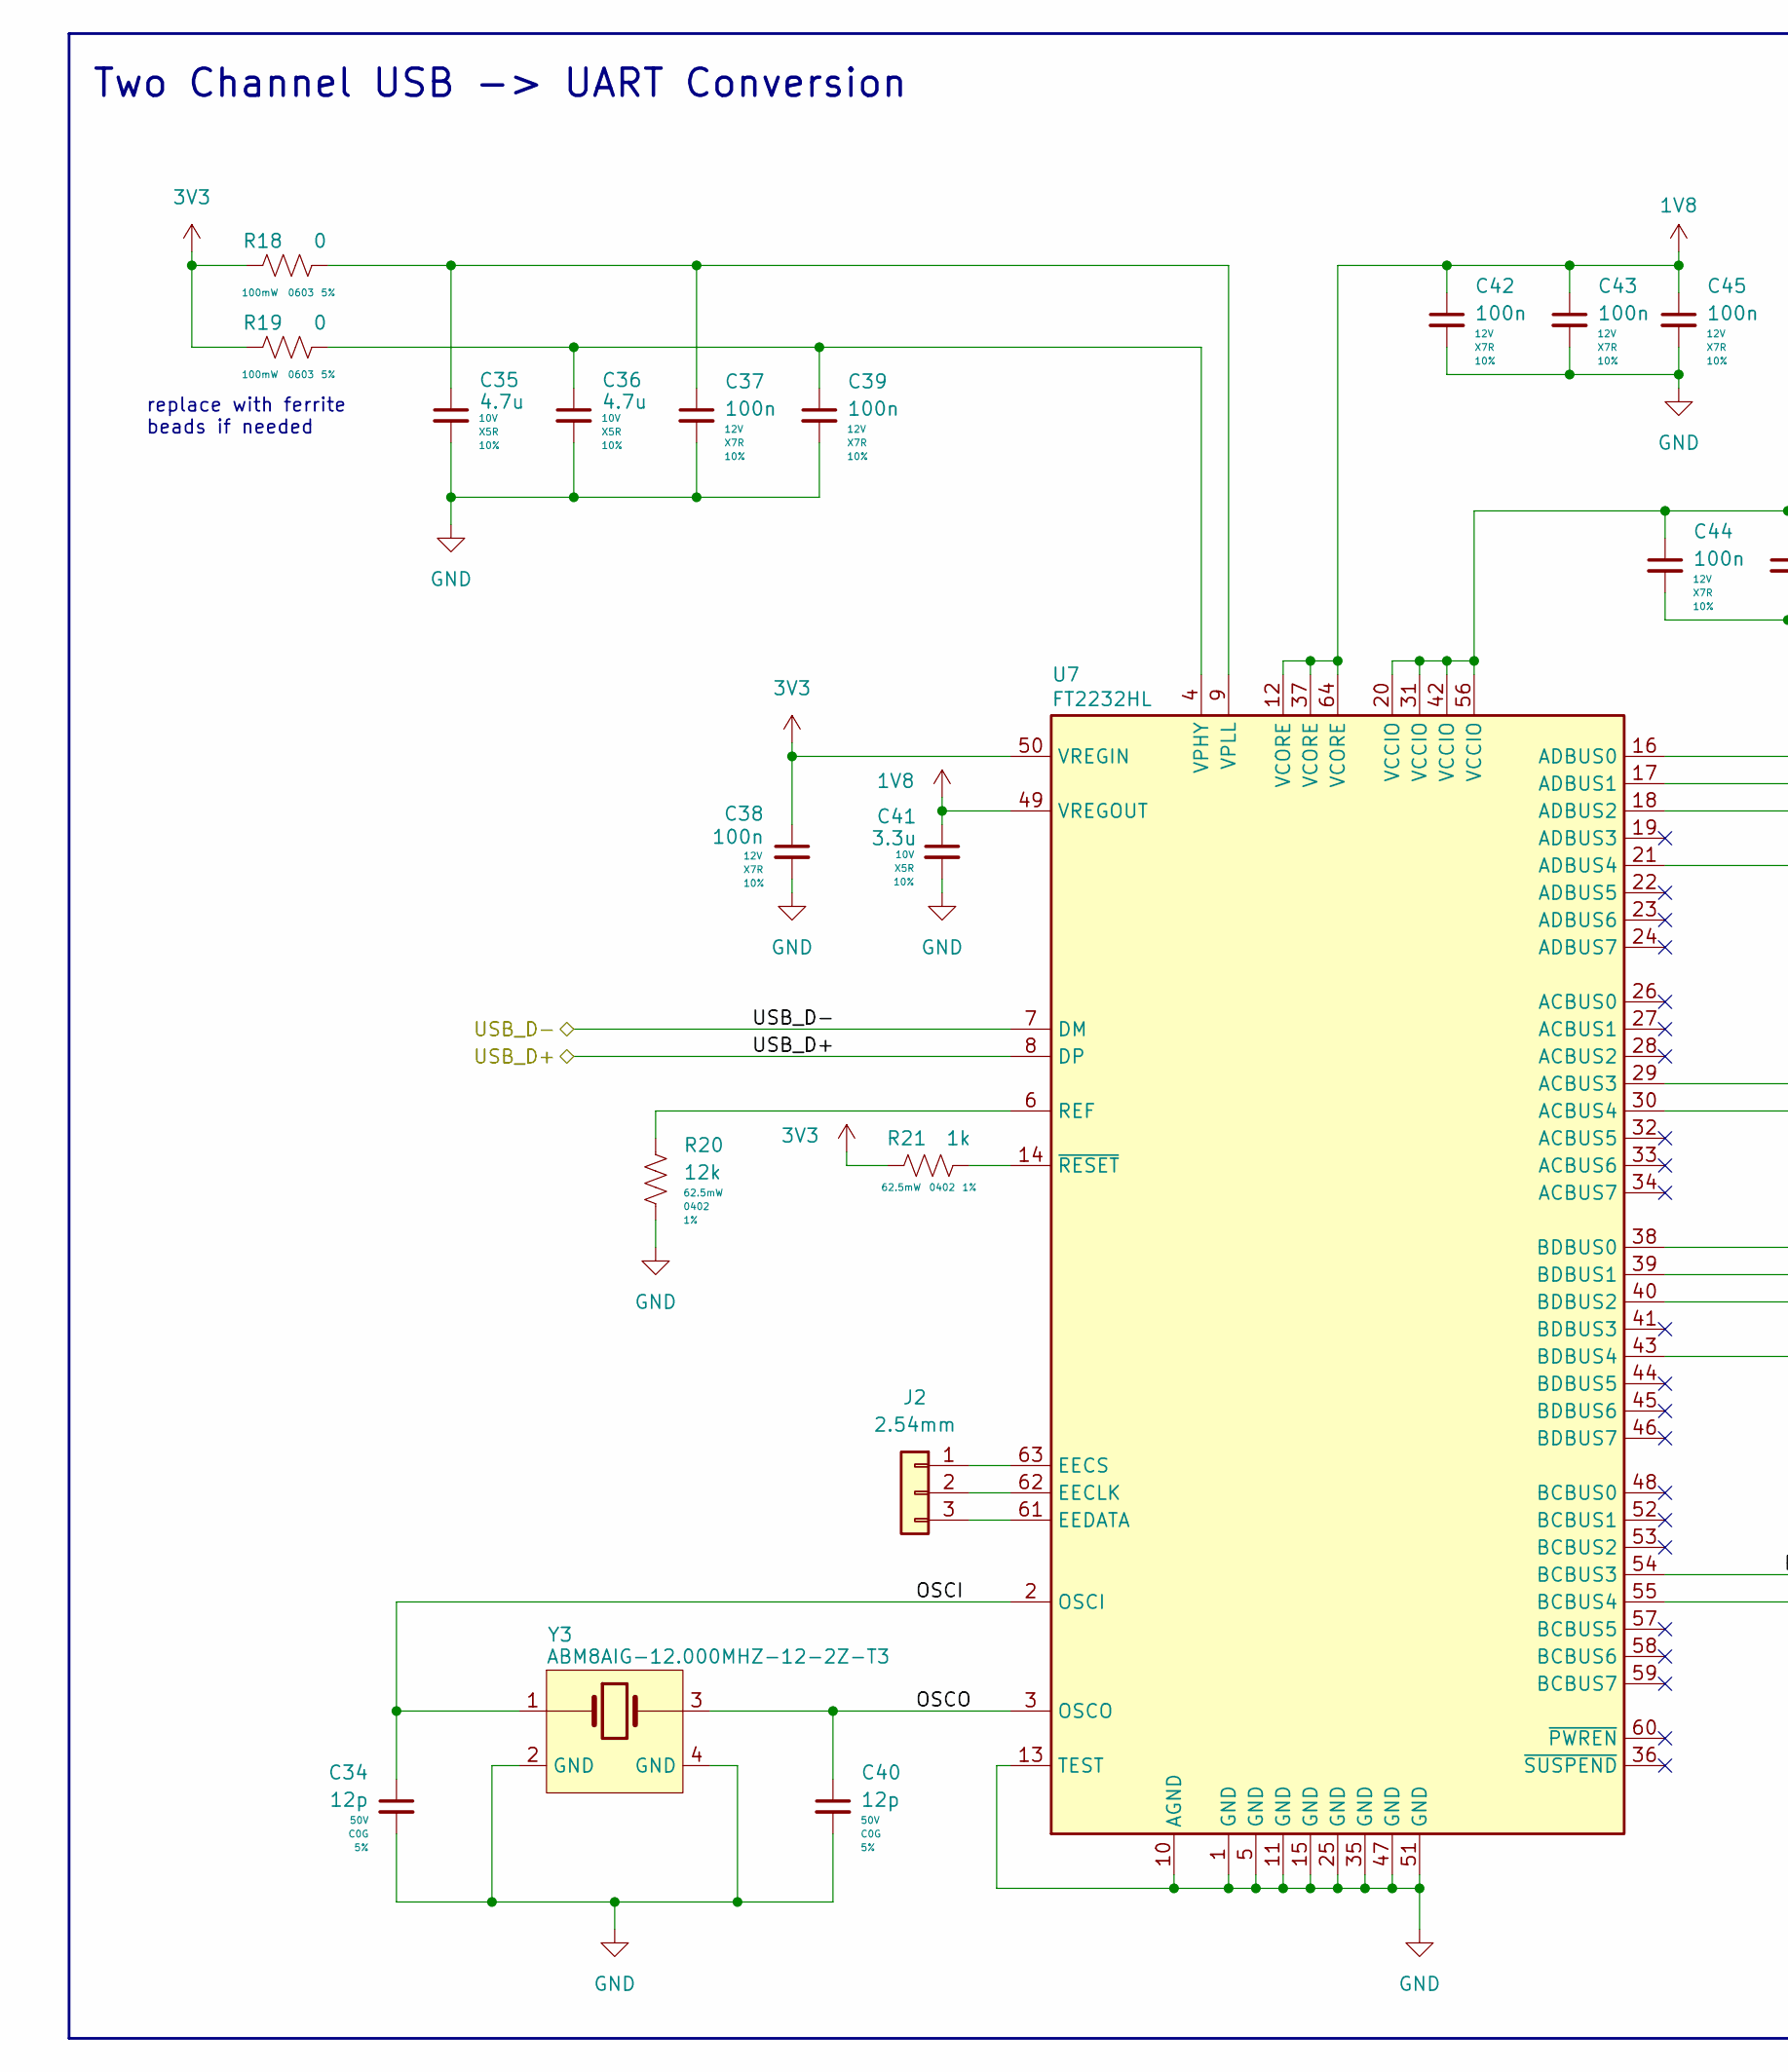
[picture p9: schematic FT2232.kicad_sch, Temperature Logger, part in row 1, column 1]

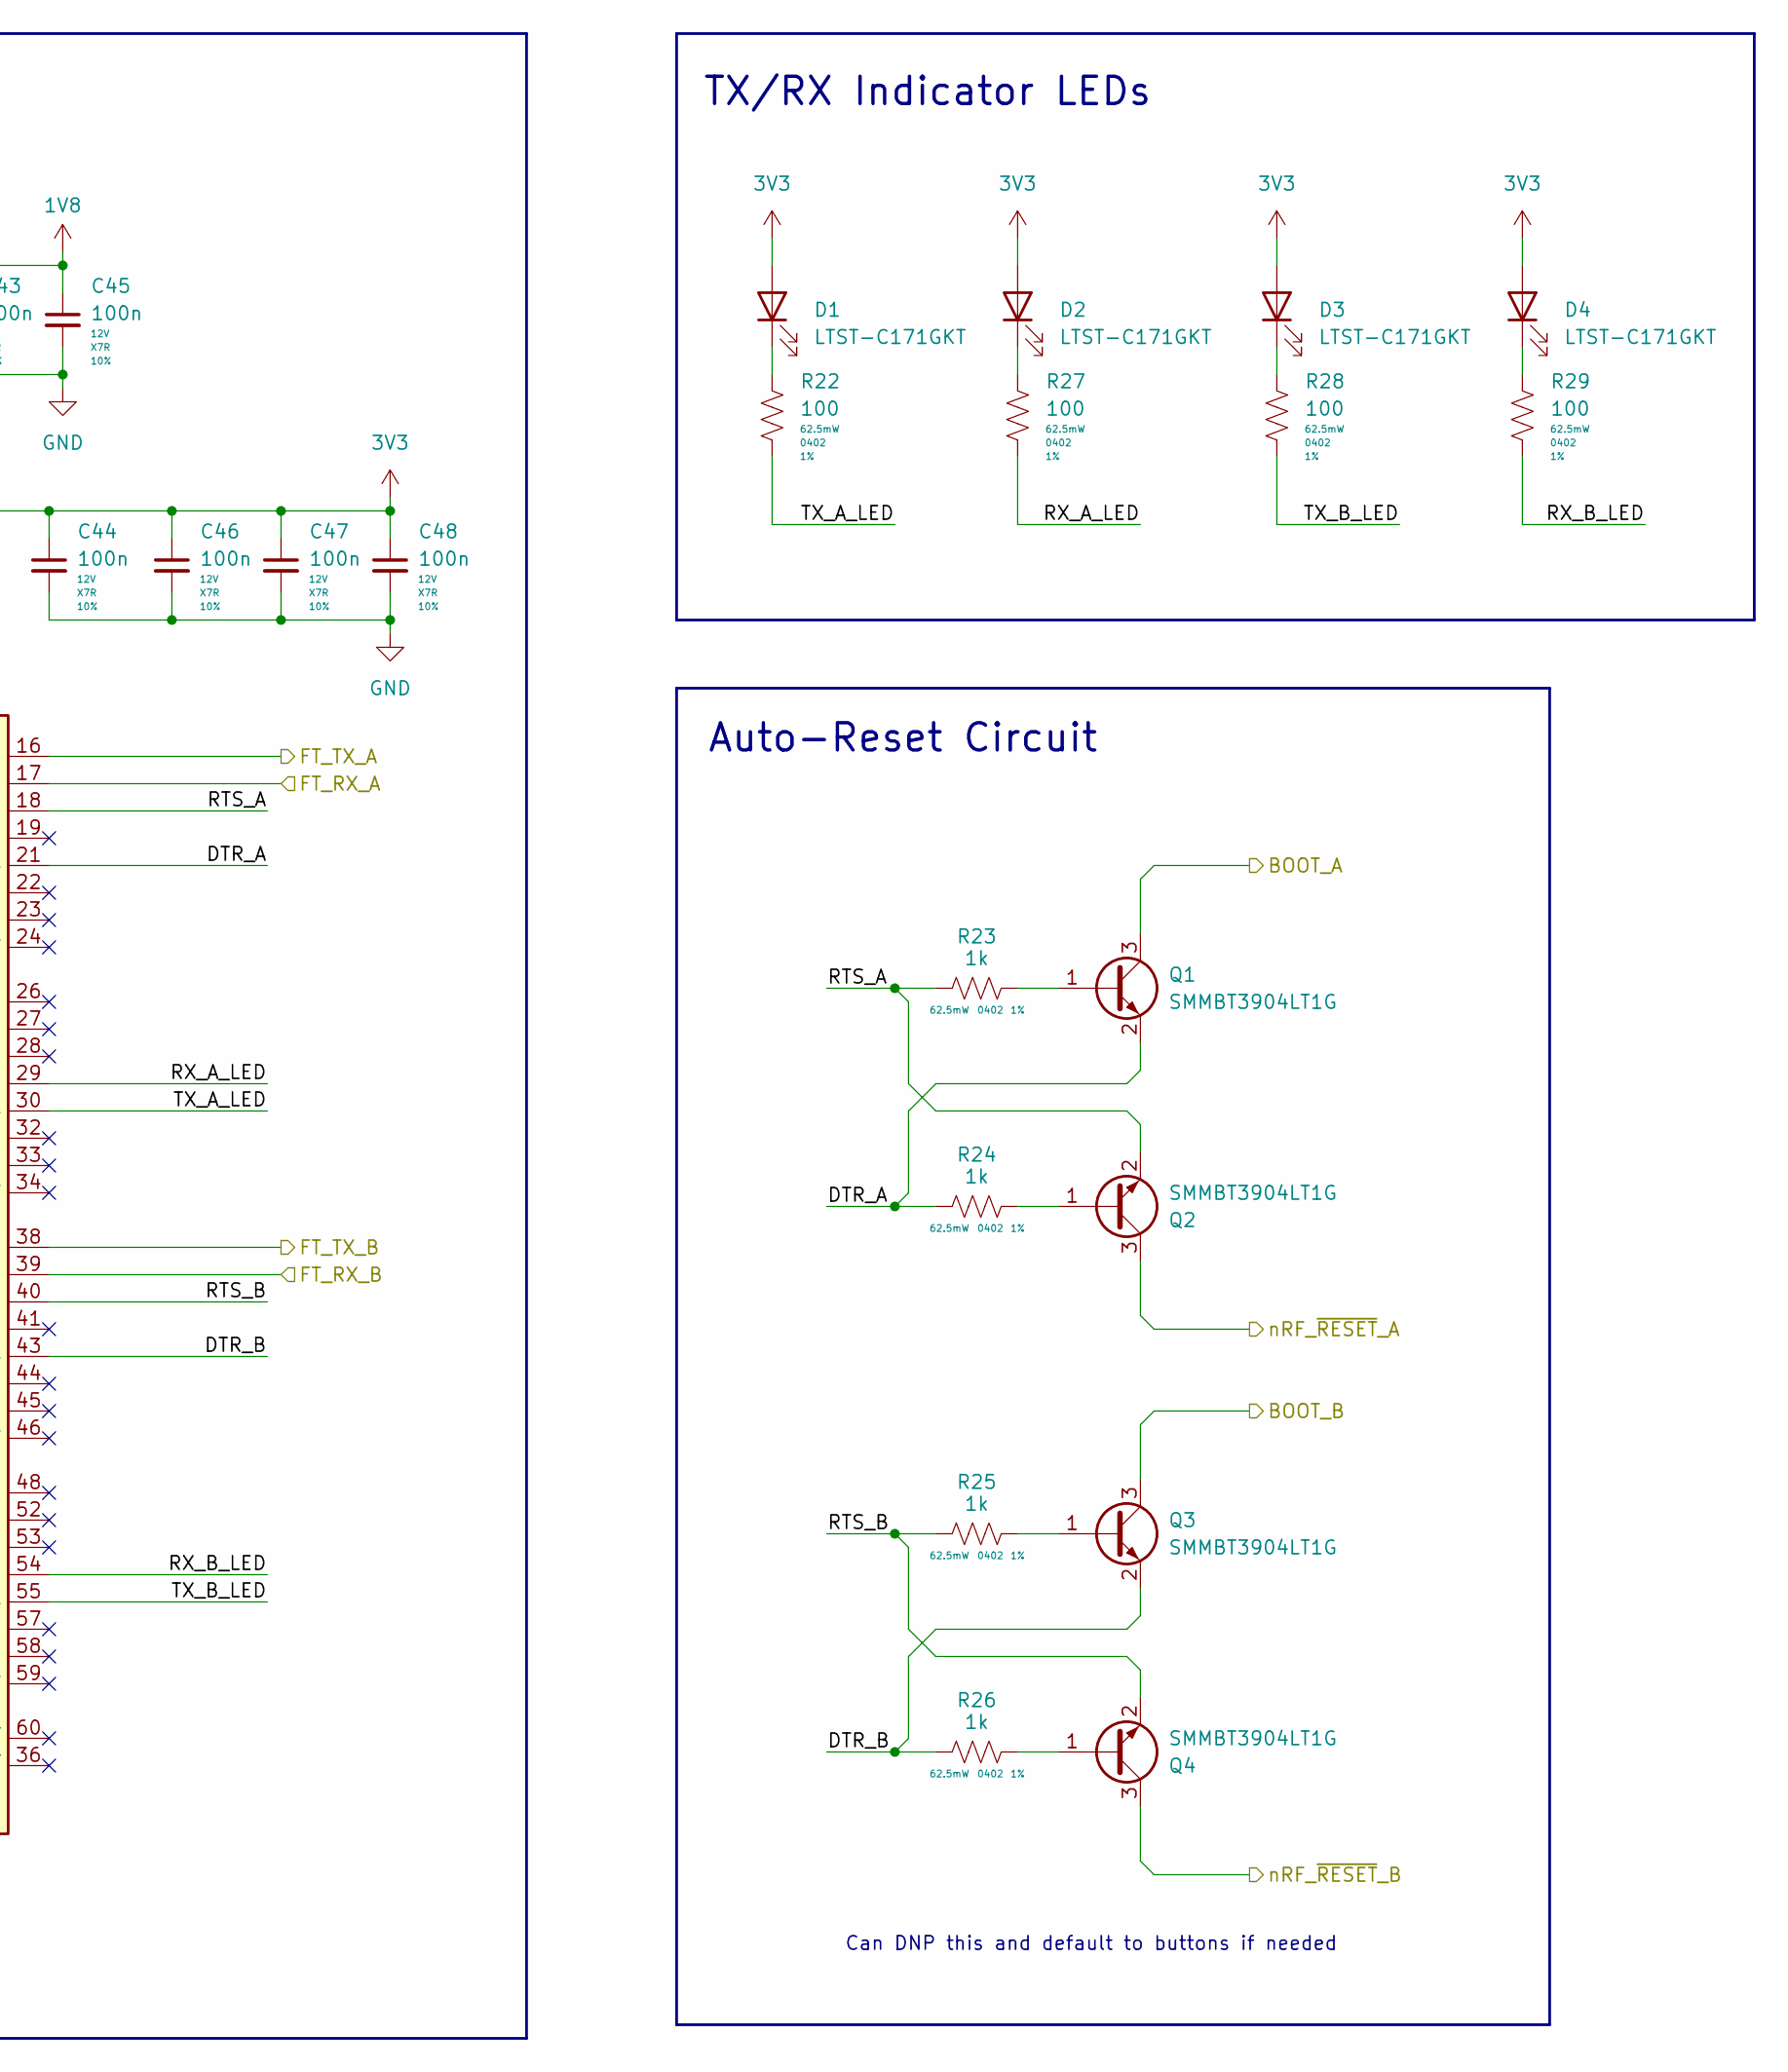
[picture p10: schematic FT2232.kicad_sch, Temperature Logger, part in row 1, column 2]

Parts:
C34, C40: 12p; C_0402_1005Metric_Pad0.74x0.62mm_HandSolder; Voltage Rating 50V; Tolerance 5%; LCSC C85875
C35, C36: 4.7u; C_0603_1608Metric_Pad1.08x0.95mm_HandSolder; Voltage Rating 10V; Tolerance 10%; LCSC C1705
C37, C38, C39, C42, C43, C44, C45, C46, C47, C48: 100n; C_0402_1005Metric_Pad0.74x0.62mm_HandSolder; Voltage Rating 12V; Tolerance 10%; LCSC C1525
C41: 3.3u; C_0603_1608Metric_Pad1.08x0.95mm_HandSolder; Voltage Rating 10V; Tolerance 10%; LCSC C51412
D1, D2, D3, D4: LTST-C171GKT; LED_0805_2012Metric; LCSC C913075
J2: 2.54mm; PinHeader_1x03_P2.54mm_Vertical
Q1, Q2, Q3, Q4: SMMBT3904LT1G; LCSC C84555
R18, R19: 0; R_0603_1608Metric_Pad0.98x0.95mm_HandSolder; Tolerance 5%; LCSC C177335
R20: 12k; R_0402_1005Metric_Pad0.72x0.64mm_HandSolder; Tolerance 1%; LCSC C114760
R21, R23, R24, R25, R26: 1k; R_0402_1005Metric_Pad0.72x0.64mm_HandSolder; Tolerance 1%; LCSC C71623
R22, R27, R28, R29: 100; R_0402_1005Metric_Pad0.72x0.64mm_HandSolder; Tolerance 1%; LCSC C82865
U7: FT2232HL; LQFP-64_10x10mm_P0.5mm; LCSC C27882
Y3: ABM8AIG-12.000MHZ-12-2Z-T3; LCSC C1985448

Connections:
1V8: C41.1, C42.1, C43.1, C45.1, U7.12 (VCORE), U7.37 (VCORE), U7.49 (VREGOUT), U7.64 (VCORE)
3V3: C38.1, C44.1, C46.1, C47.1, C48.1, D1.2 (A), D2.2 (A), D3.2 (A), D4.2 (A), R18.1, R19.1, R21.1, U7.20 (VCCIO), U7.31 (VCCIO), U7.42 (VCCIO), U7.50 (VREGIN), U7.56 (VCCIO); also elsewhere on the board
/Receiver/BOOT_B: Q3.3 (C); also elsewhere on the board
/Receiver/nRF_~RESET_B: Q4.3 (C); also elsewhere on the board
/Transmitter/BOOT_A: Q1.3 (C); also elsewhere on the board
/Transmitter/nRF_~RESET_A: Q2.3 (C); also elsewhere on the board
/USB to UART/FT2232/DTR_A: Q1.2 (E), R24.1, U7.21 (ADBUS4)
/USB to UART/FT2232/DTR_B: Q3.2 (E), R26.1, U7.43 (BDBUS4)
/USB to UART/FT2232/OSCI: C34.1, U7.2 (OSCI), Y3.1
/USB to UART/FT2232/OSCO: C40.1, U7.3 (OSCO), Y3.3
/USB to UART/FT2232/RTS_A: Q2.2 (E), R23.1, U7.18 (ADBUS2)
/USB to UART/FT2232/RTS_B: Q4.2 (E), R25.1, U7.40 (BDBUS2)
/USB to UART/FT2232/RX_A_LED: R27.2, U7.29 (ACBUS3)
/USB to UART/FT2232/RX_B_LED: R29.2, U7.54 (BCBUS3)
/USB to UART/FT2232/TX_A_LED: R22.2, U7.30 (ACBUS4)
/USB to UART/FT2232/TX_B_LED: R28.2, U7.55 (BCBUS4)
/USB to UART/FT2232/USB_D+: U7.8 (DP); also elsewhere on the board
/USB to UART/FT2232/USB_D-: U7.7 (DM); also elsewhere on the board
/USB to UART/FT_RX_A: U7.17 (ADBUS1); also elsewhere on the board
/USB to UART/FT_RX_B: U7.39 (BDBUS1); also elsewhere on the board
/USB to UART/FT_TX_A: U7.16 (ADBUS0); also elsewhere on the board
/USB to UART/FT_TX_B: U7.38 (BDBUS0); also elsewhere on the board
GND: C34.2, C35.2, C36.2, C37.2, C38.2, C39.2, C40.2, C41.2, C42.2, C43.2, C44.2, C45.2, C46.2, C47.2, C48.2, R20.2, U7.1 (GND), U7.5 (GND), U7.10 (AGND), U7.11 (GND), U7.13 (TEST), U7.15 (GND), U7.25 (GND), U7.35 (GND), U7.47 (GND), U7.51 (GND), Y3.2 (GND), Y3.4 (GND); also elsewhere on the board
unnamed: D1.1 (K), R22.1
unnamed: D2.1 (K), R27.1
unnamed: D3.1 (K), R28.1
unnamed: D4.1 (K), R29.1
unnamed: J2.1, U7.63 (EECS)
unnamed: J2.2, U7.62 (EECLK)
unnamed: J2.3, U7.61 (EEDATA)
unnamed: Q1.1 (B), R23.2
unnamed: Q2.1 (B), R24.2
unnamed: Q3.1 (B), R25.2
unnamed: Q4.1 (B), R26.2
unnamed: R20.1, U7.6 (REF)
unnamed: C36.1, C39.1, R19.2, U7.4 (VPHY)
unnamed: C35.1, C37.1, R18.2, U7.9 (VPLL)
unnamed: R21.2, U7.14 (~RESET)

Notes on the sheet:
Auto-Reset Circuit
replace with ferrite beads if needed
TX/RX Indicator LEDs
Two Channel USB -> UART Conversion
Can DNP this and default to buttons if needed

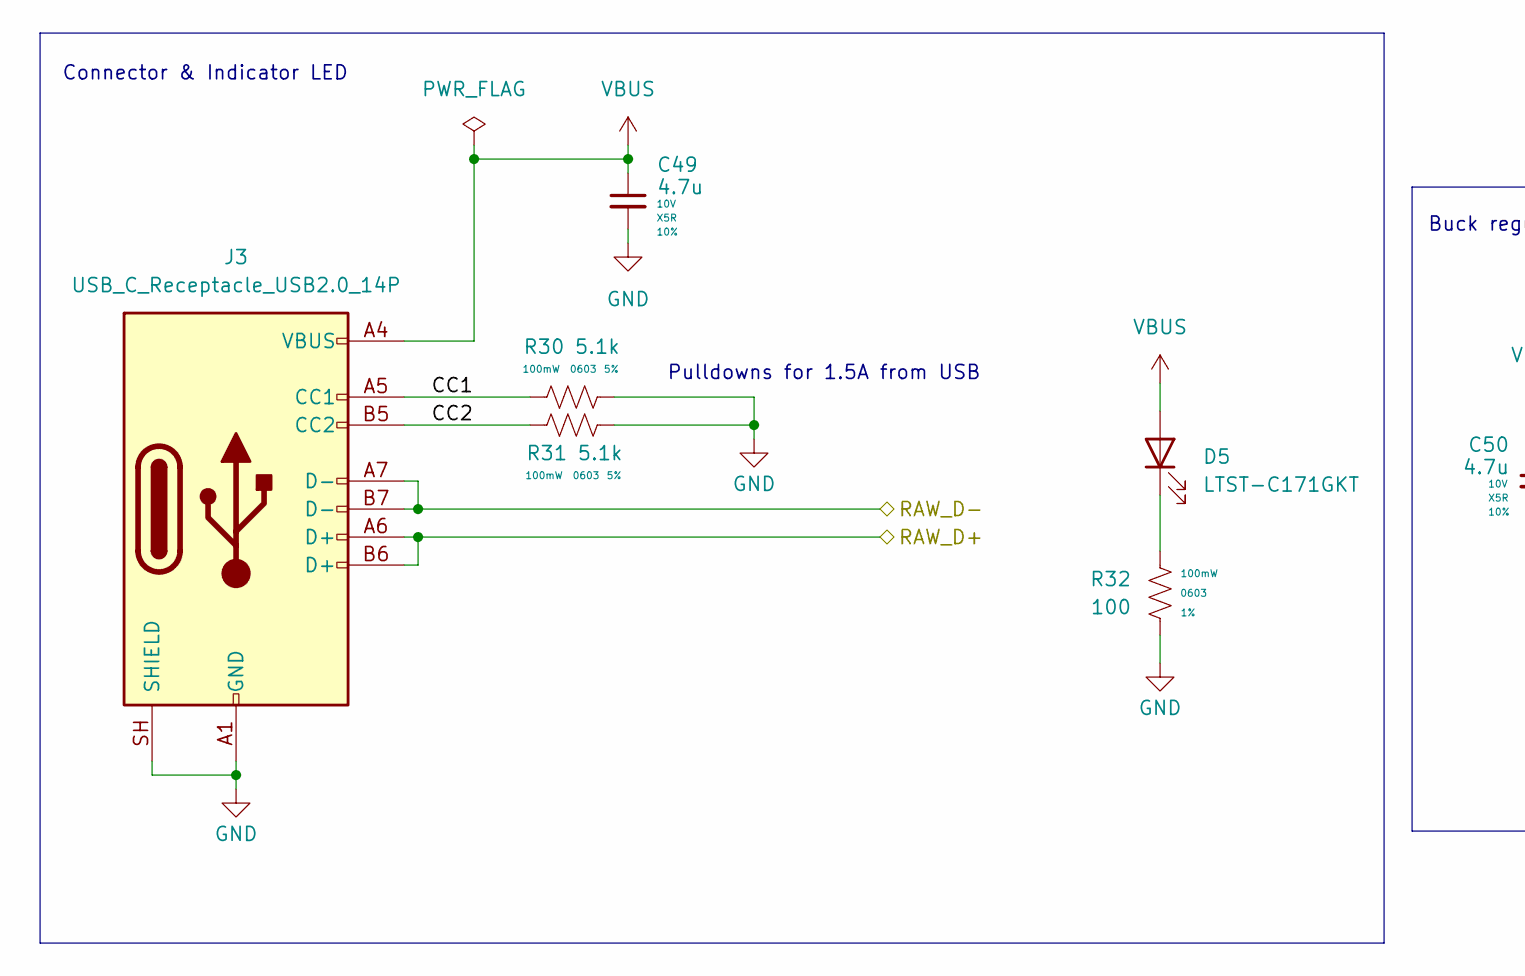
[picture p11: schematic USB-C_connector.kicad_sch, Temperature Logger, part in row 1, column 1]

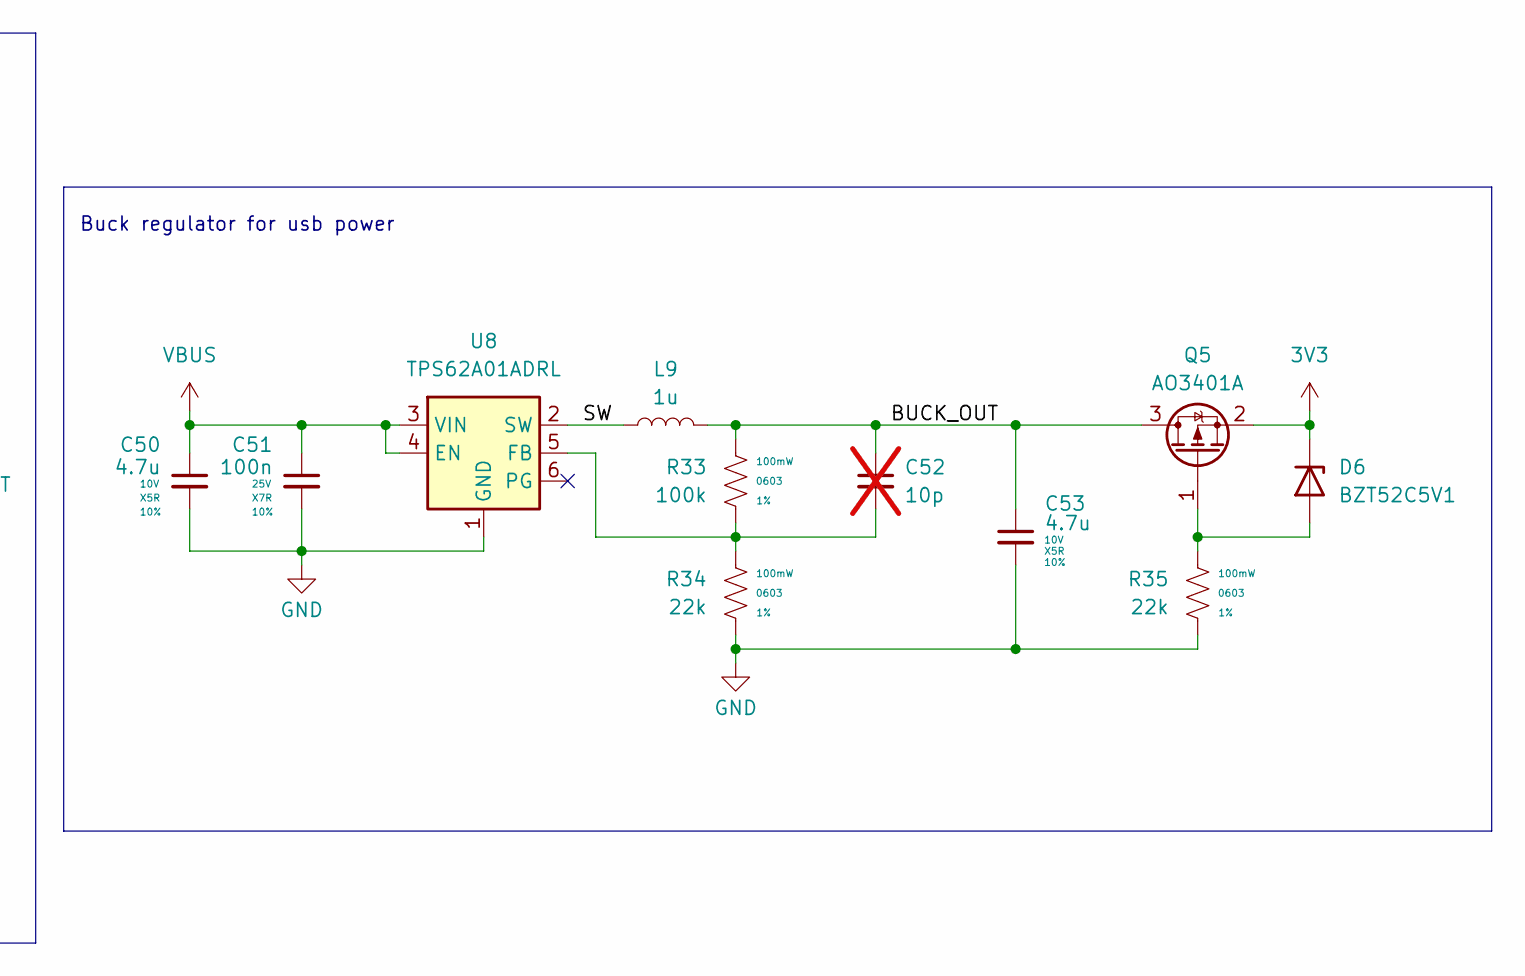
[picture p12: schematic USB-C_connector.kicad_sch, Temperature Logger, part in row 1, column 2]

Parts:
C49, C50: 4.7u; C_0603_1608Metric_Pad1.08x0.95mm_HandSolder; Voltage Rating 10V; Tolerance 10%; LCSC C1705
C51: 100n; C_0603_1608Metric_Pad1.08x0.95mm_HandSolder; Voltage Rating 25V; Tolerance 10%; LCSC C1590
C52: 10p; C_0603_1608Metric; not fitted
C53: 4.7u; C_0603_1608Metric; Voltage Rating 10V; Tolerance 10%; LCSC C1705
D5: LTST-C171GKT; LED_0805_2012Metric; LCSC C913075
D6: BZT52C5V1; D_SOD-123; LCSC C2117
J3: USB_C_Receptacle_USB2.0_14P; USB_C_Receptacle_GCT_USB4105-xx-A_16P_TopMnt_Horizontal; LCSC C3020560
L9: 1u; L_1008_2520Metric_Pad1.43x2.20mm_HandSolder; LCSC C435392
Q5: AO3401A; SOT-23; LCSC C15127
R30, R31: 5.1k; R_0603_1608Metric_Pad0.98x0.95mm_HandSolder; Tolerance 5%; LCSC C14677
R32: 100; R_0603_1608Metric_Pad0.98x0.95mm_HandSolder; Tolerance 1%; LCSC C105588
R33: 100k; R_0603_1608Metric_Pad0.98x0.95mm_HandSolder; Tolerance 1%; LCSC C14675
R34, R35: 22k; R_0603_1608Metric_Pad0.98x0.95mm_HandSolder; Tolerance 1%; LCSC C114065
U8: TPS62A01ADRL; SOT-563; LCSC C5181455

Connections:
3V3: D6.1 (K), Q5.2 (S); also elsewhere on the board
/USB to UART/USB Receptical/BUCK_OUT: C52.1, C53.1, L9.2, Q5.3 (D), R33.2
/USB to UART/USB Receptical/CC1: J3.A5 (CC1), R30.1
/USB to UART/USB Receptical/CC2: J3.B5 (CC2), R31.1
/USB to UART/USB Receptical/RAW_D+: J3.A6 (D+), J3.B6 (D+); also elsewhere on the board
/USB to UART/USB Receptical/RAW_D-: J3.A7 (D-), J3.B7 (D-); also elsewhere on the board
/USB to UART/USB Receptical/SW: L9.1, U8.2 (SW)
GND: C49.2, C50.2, C51.2, C53.2, J3.A1 (GND), J3.A12 (GND), J3.B1 (GND), J3.B12 (GND), J3.SH (SHIELD), R30.2, R31.2, R32.1, R34.1, R35.1, U8.1 (GND); also elsewhere on the board
unnamed: D5.1 (K), R32.2
unnamed: D6.2 (A), Q5.1 (G), R35.2
unnamed: C52.2, R33.1, R34.2, U8.5 (FB)
VBUS: C49.1, C50.1, C51.1, D5.2 (A), J3.A4 (VBUS), J3.A9 (VBUS), J3.B4 (VBUS), J3.B9 (VBUS), U8.3 (VIN), U8.4 (EN); also elsewhere on the board

Notes on the sheet:
Connector & Indicator LED
Buck regulator for usb power
Pulldowns for 1.5A from USB

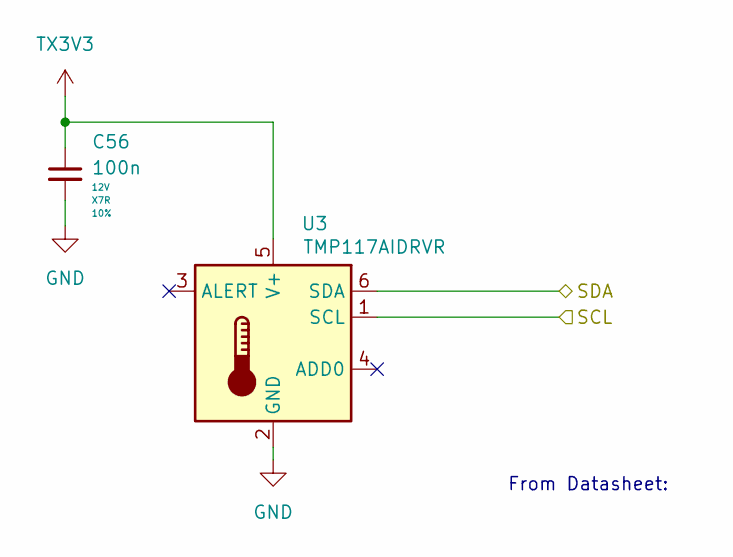
[picture p13: schematic temp_sense.kicad_sch, Temperature Logger]

Parts:
C56: 100n; C_0402_1005Metric_Pad0.74x0.62mm_HandSolder; Voltage Rating 12V; Tolerance 10%; LCSC C1525
U3: TMP117AIDRVR; WSON-6-1EP_2x2mm_P0.65mm_EP1x1.6mm; LCSC C699536

Connections:
/Transmitter/TX Microcontroller/SCL: U3.1 (SCL); also elsewhere on the board
/Transmitter/TX Microcontroller/SDA: U3.6 (SDA); also elsewhere on the board
GND: C56.2, U3.2 (GND); also elsewhere on the board
TX3V3: C56.1, U3.5 (V+); also elsewhere on the board

Notes on the sheet:
From Datasheet:
