SEED-Team-512-NWTL/Temp-Logger/Temp-Logger.kicad_pcb

## KiCad design Temp-Logger.kicad_pcb (continued)

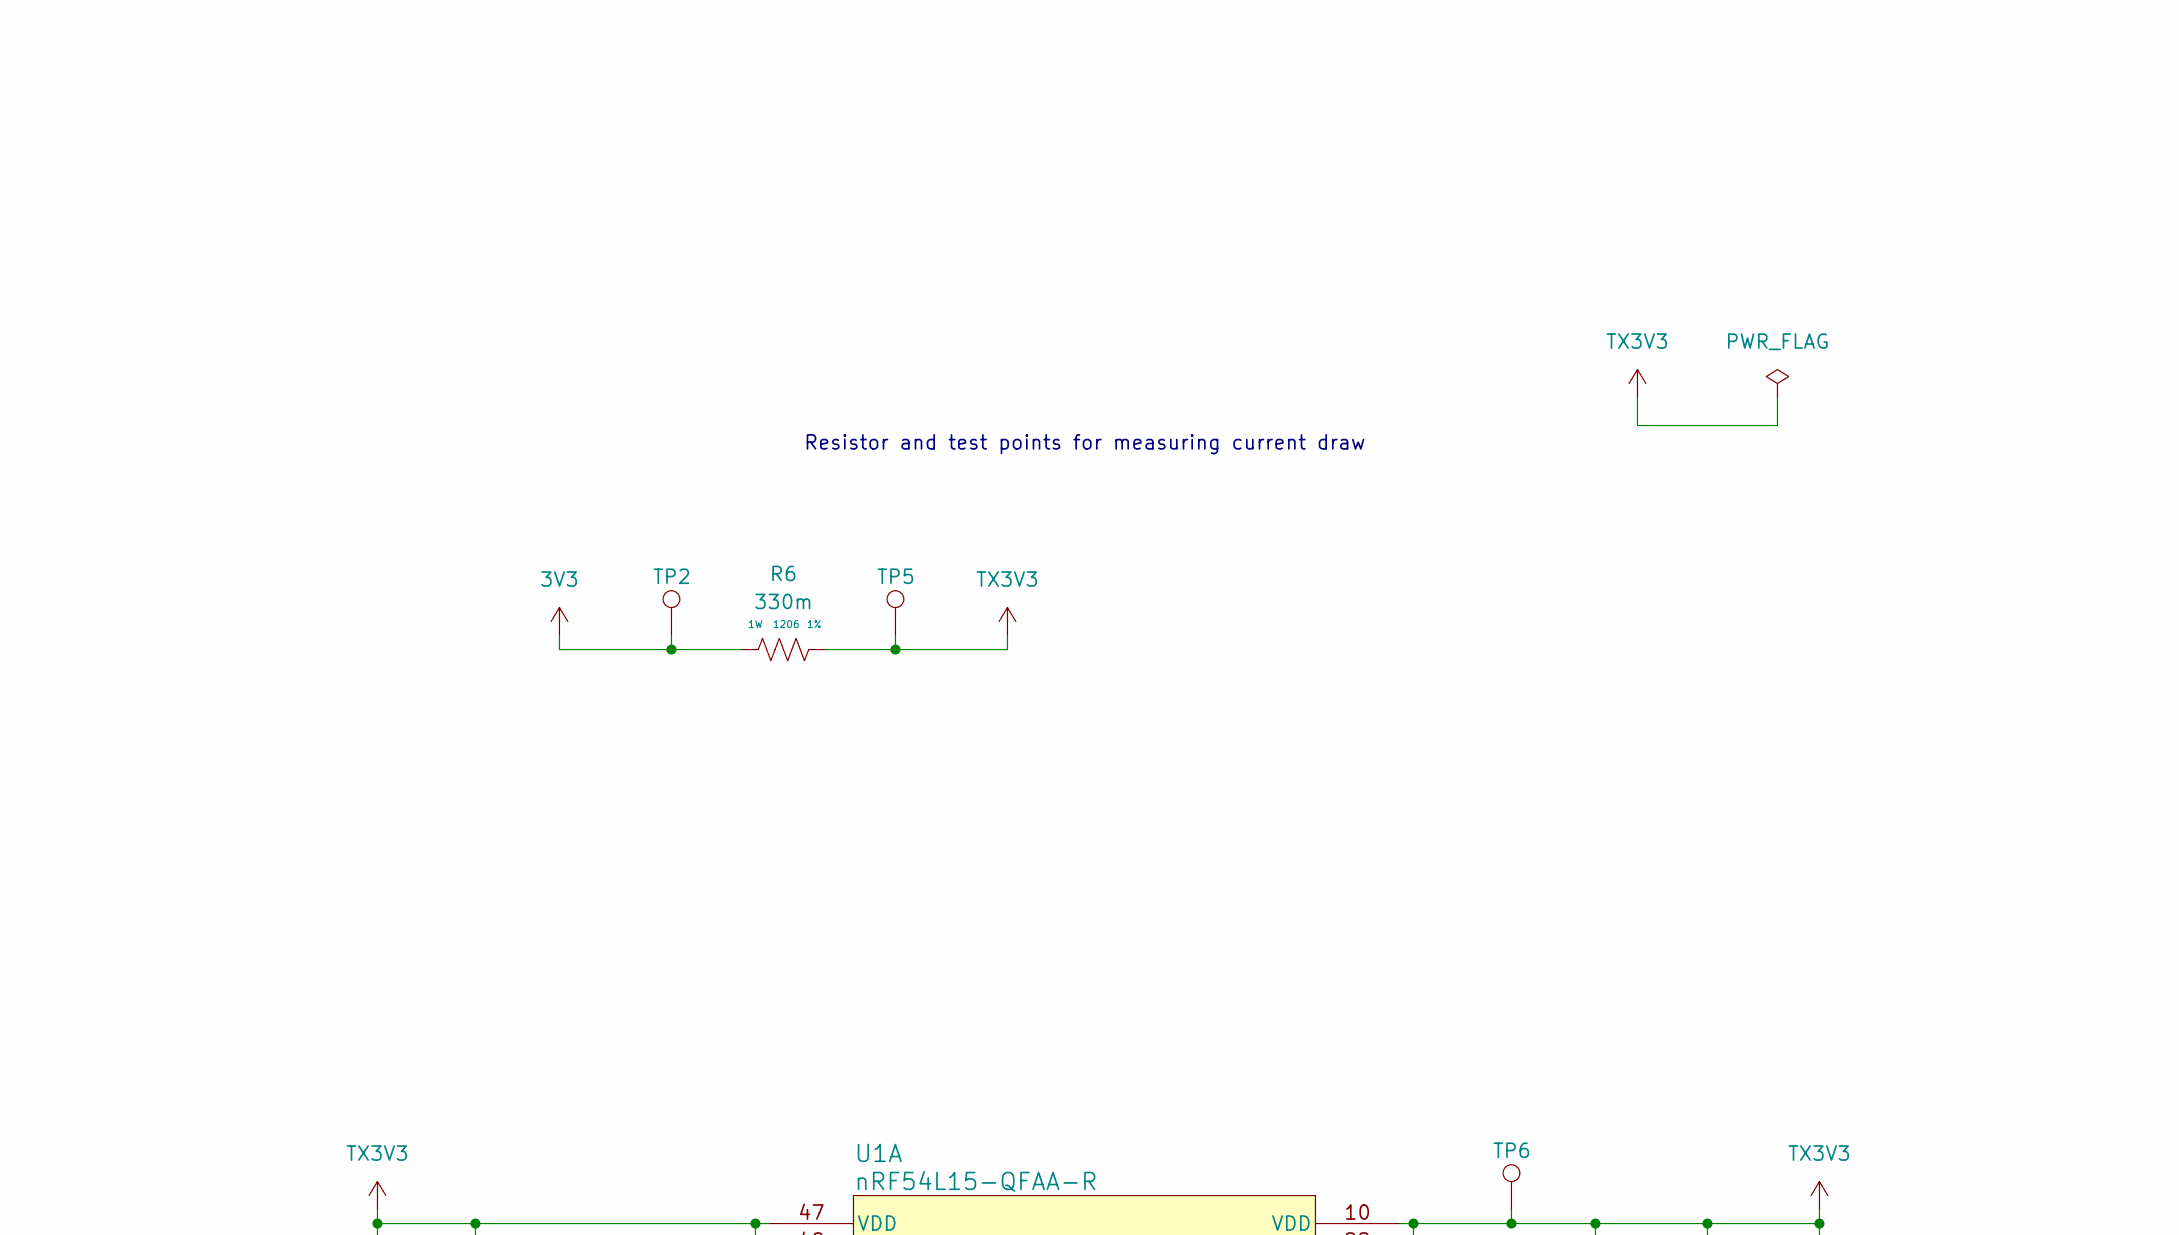
[picture p14: schematic tx_microcontroller.kicad_sch, Temperature Logger, part in row 1, column 1]

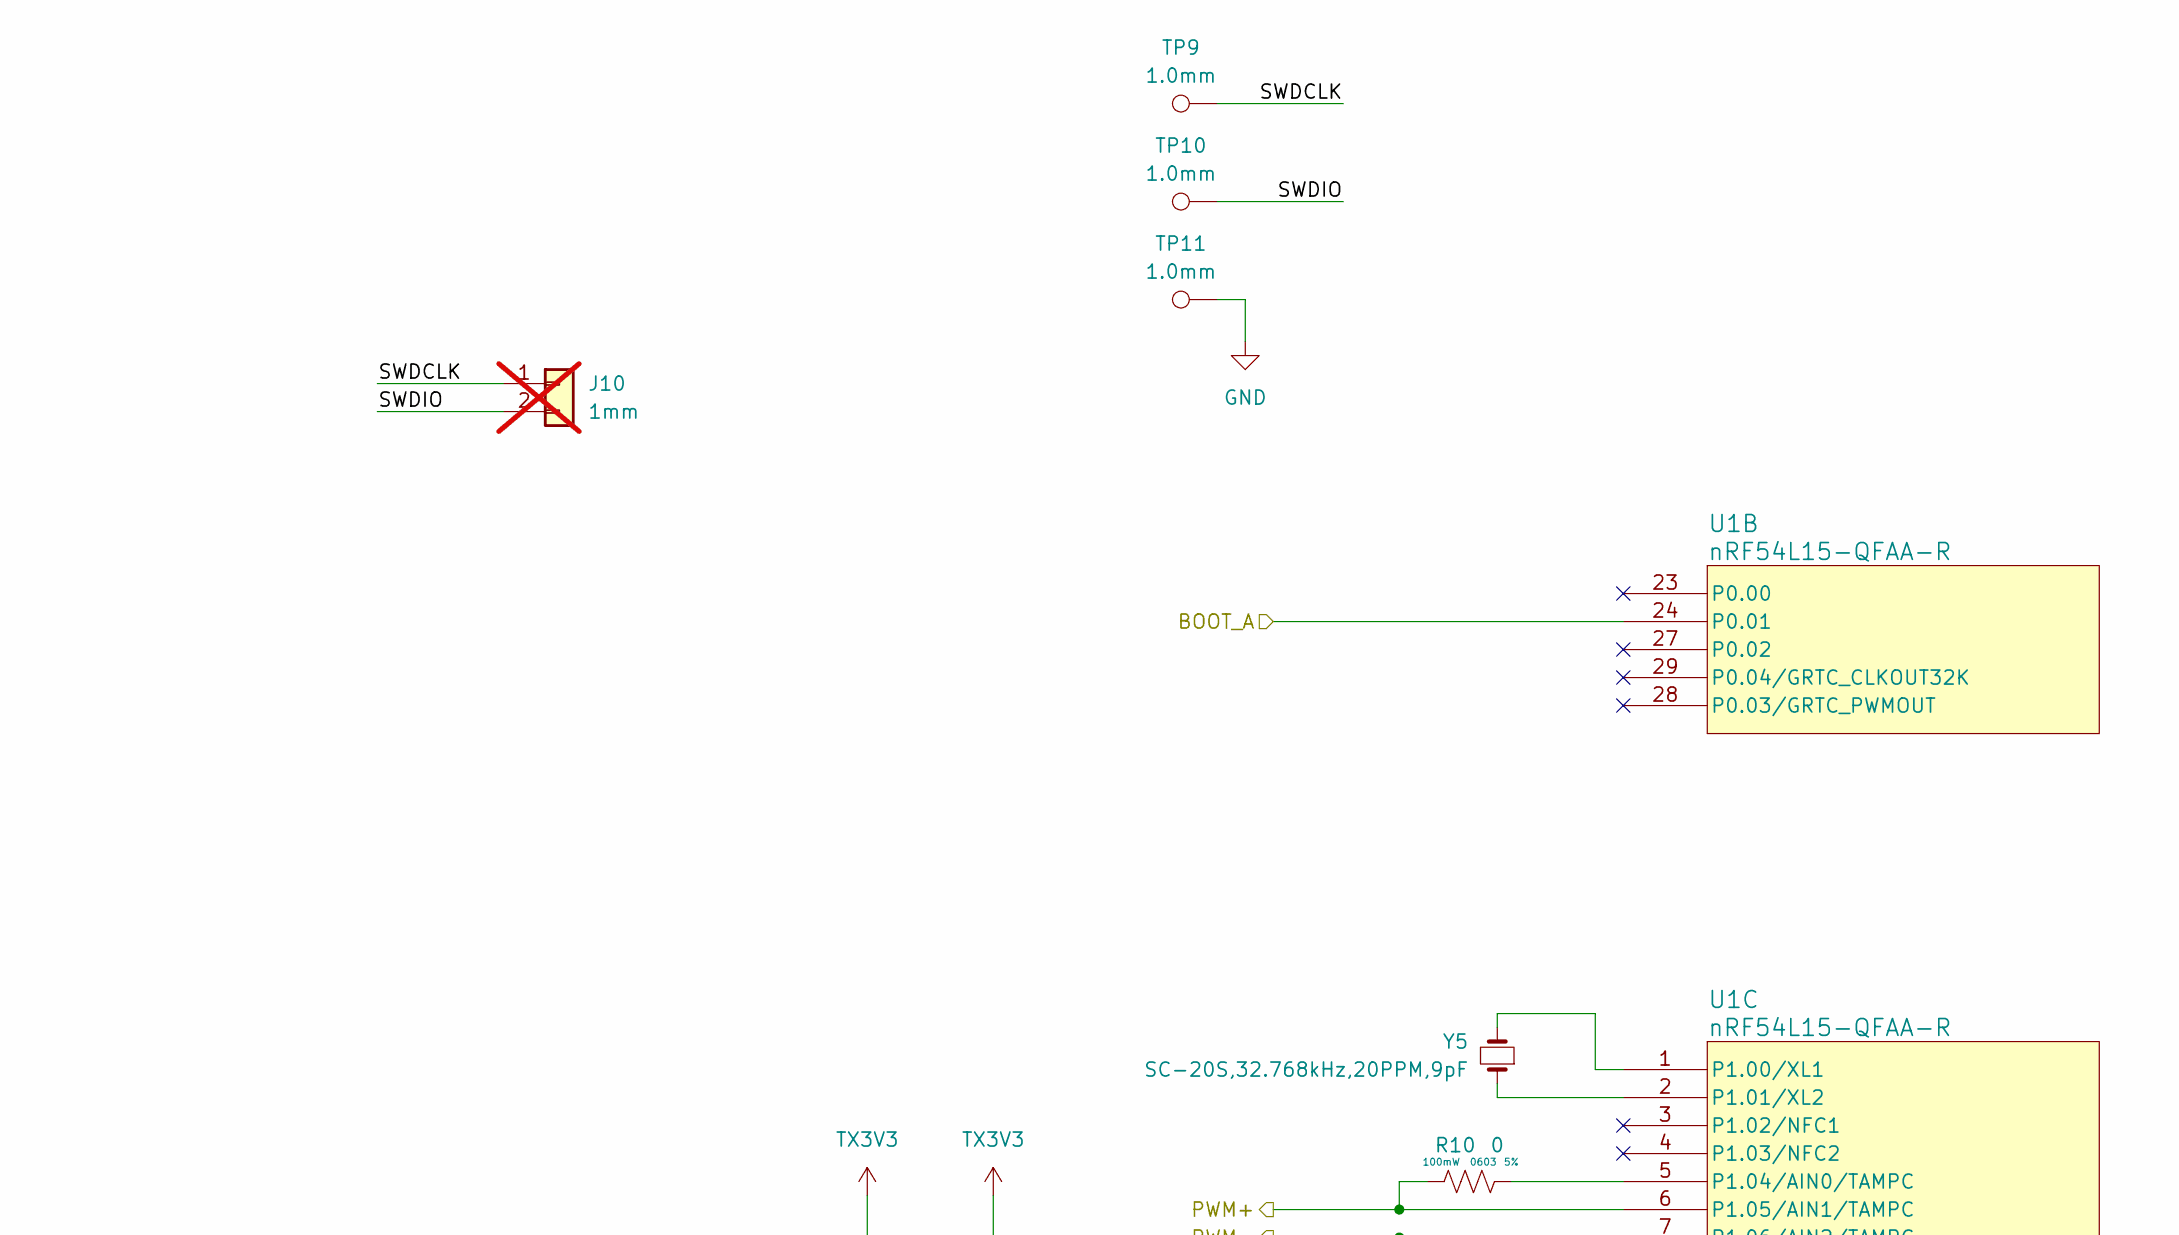
[picture p15: schematic tx_microcontroller.kicad_sch, Temperature Logger, part in row 1, column 2]

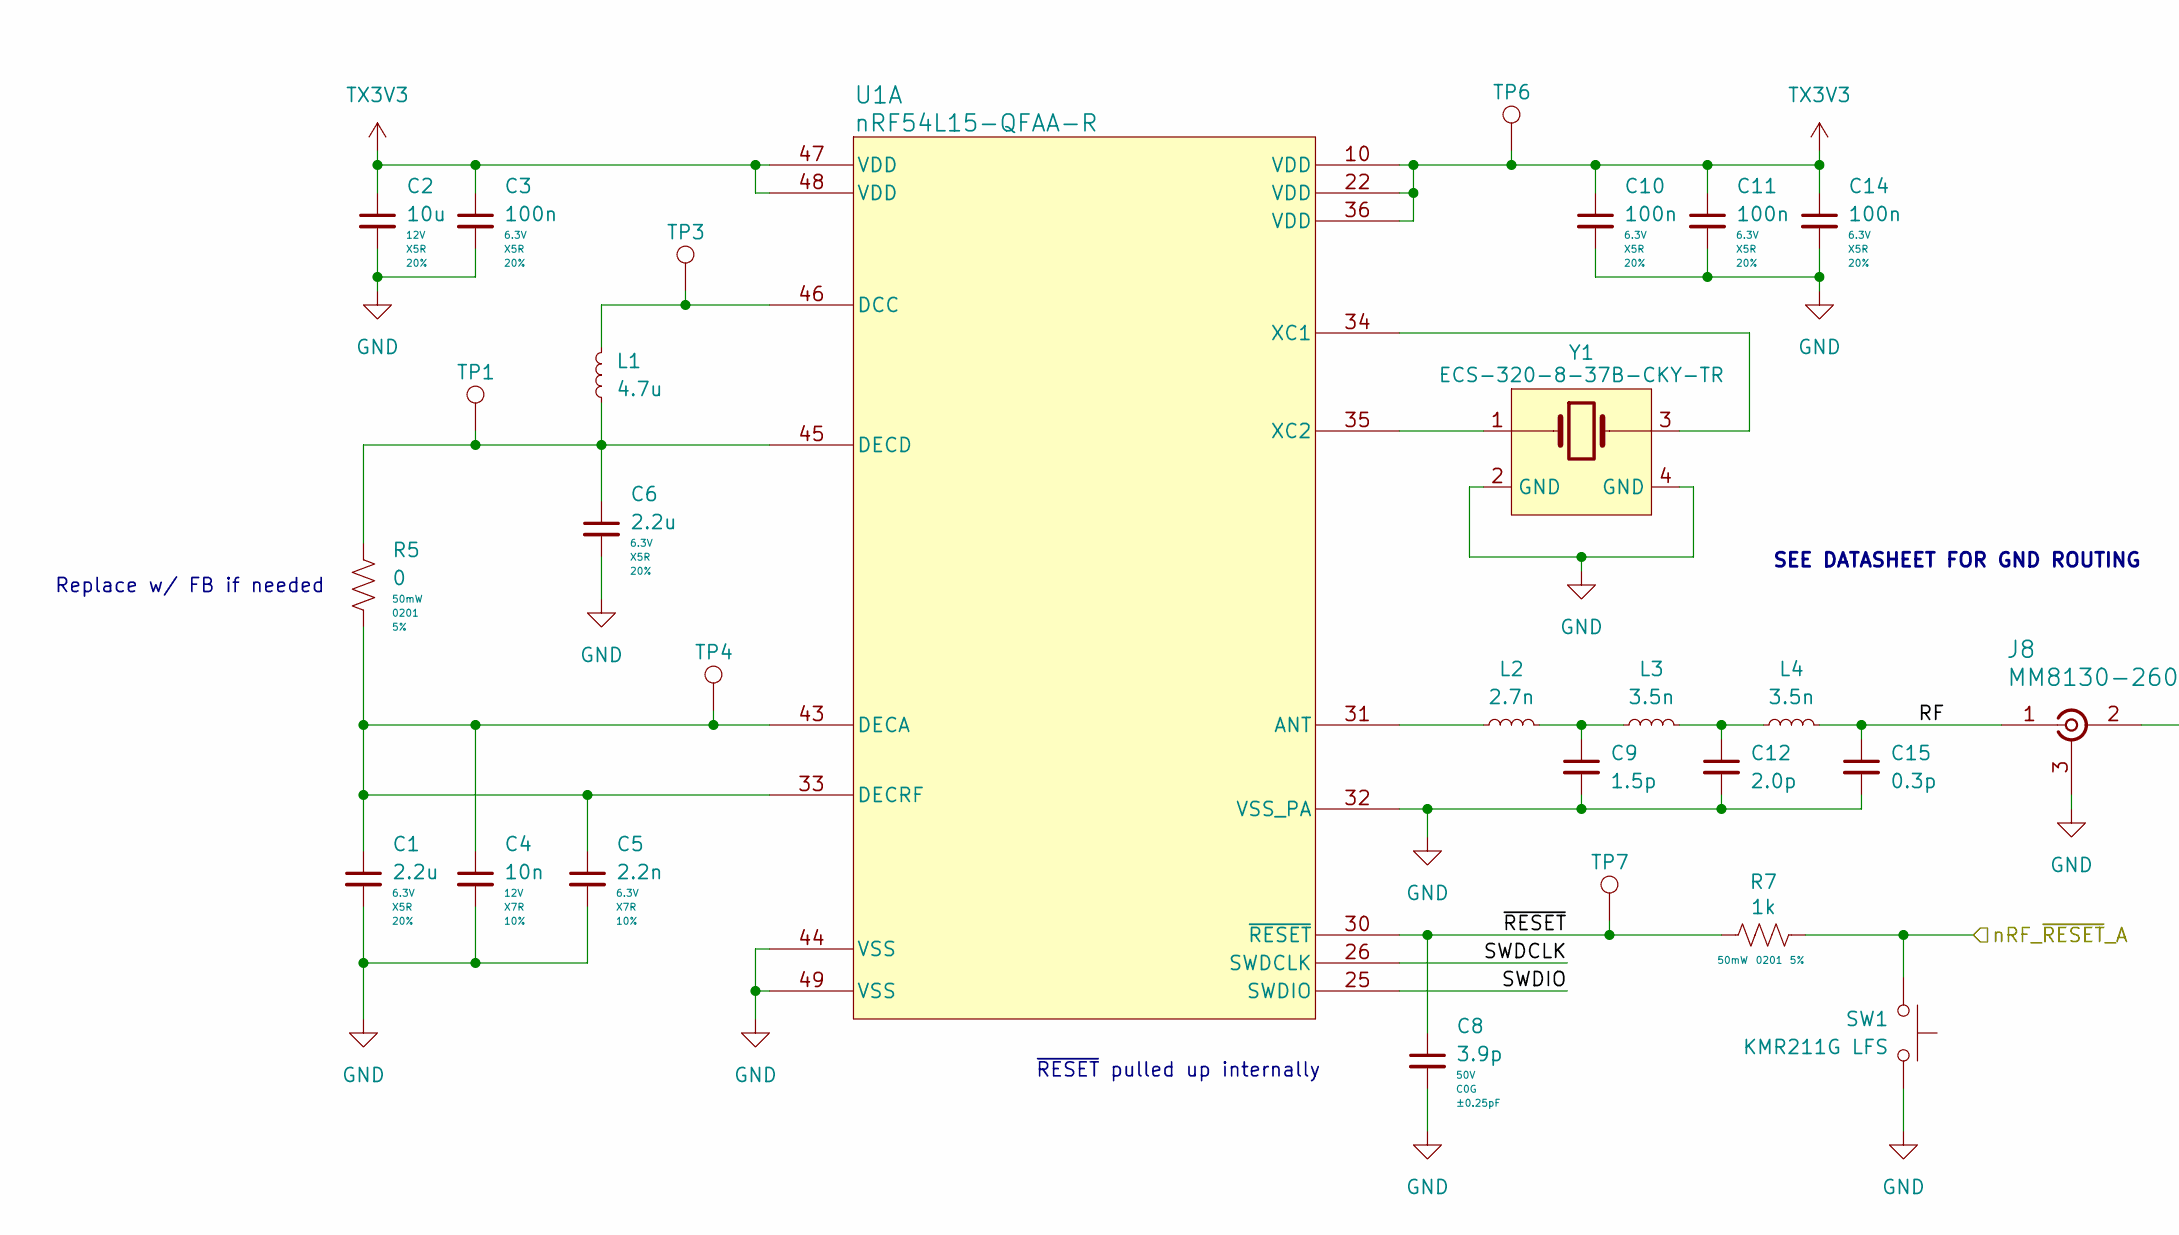
[picture p16: schematic tx_microcontroller.kicad_sch, Temperature Logger, part in row 2, column 1]

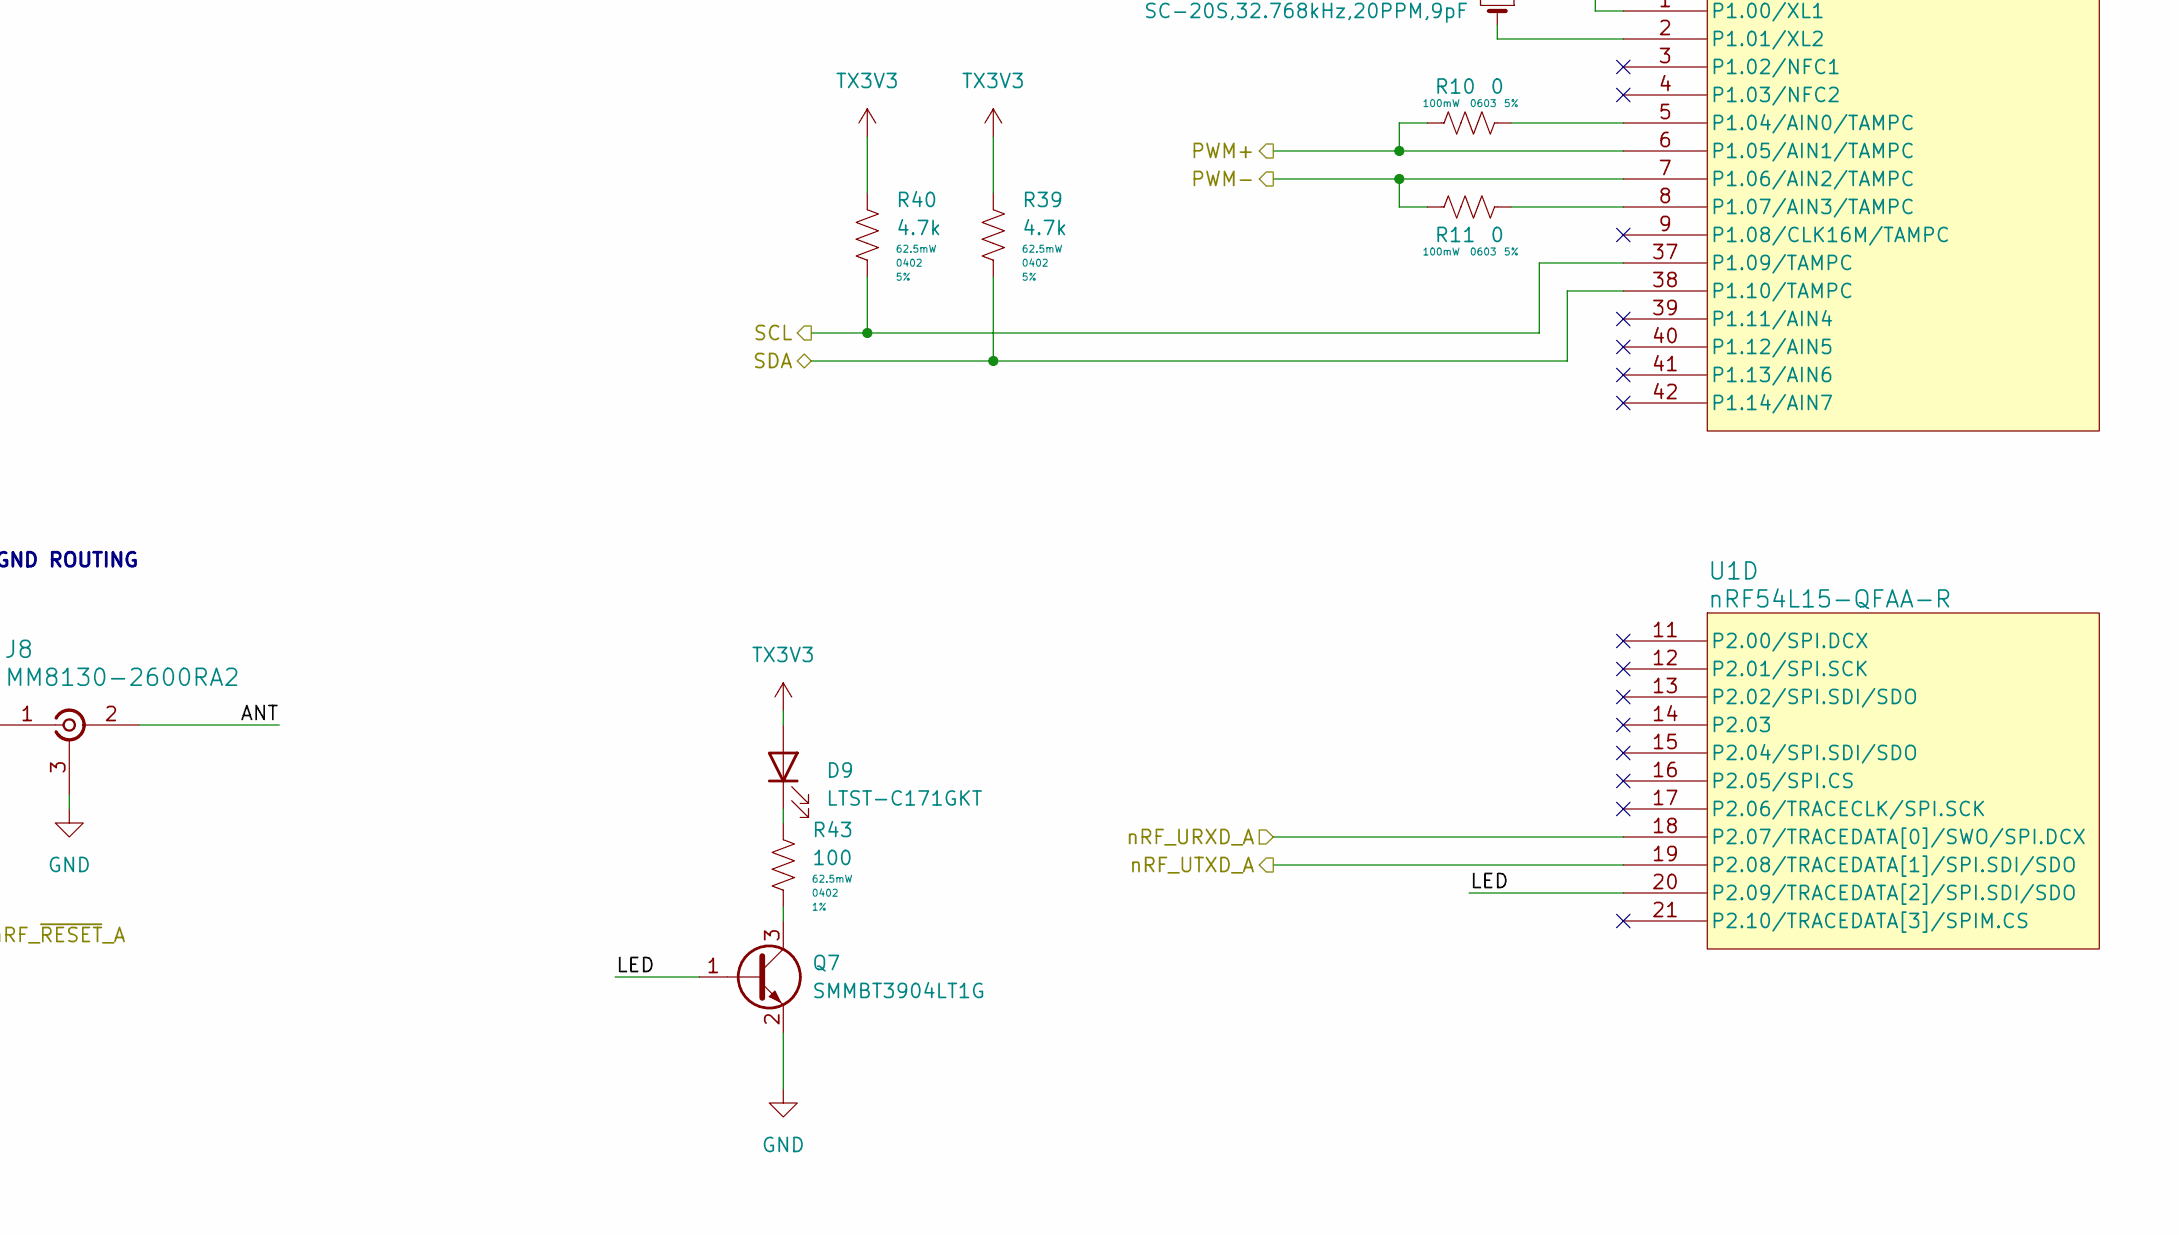
[picture p17: schematic tx_microcontroller.kicad_sch, Temperature Logger, part in row 2, column 2]

Parts:
C1, C6: 2.2u; C_0201_0603Metric; Voltage Rating 6.3V; Tolerance 20%; LCSC C76933
C2: 10u; C_0402_1005Metric_Pad0.74x0.62mm_HandSolder; Voltage Rating 12V; Tolerance 20%; LCSC C15525
C3: 100n; C_0201_0603Metric; Voltage Rating 6.3V; Tolerance 20%; LCSC C284992
C4: 10n; C_0201_0603Metric; Voltage Rating 12V; Tolerance 10%; LCSC C309453
C5: 2.2n; C_0201_0603Metric; Voltage Rating 6.3V; Tolerance 10%; LCSC C526947
C8: 3.9p; C_0201_0603Metric; Voltage Rating 50V; Tolerance ±0.25pF; LCSC C76926
C9: 1.5p; C_0201_0603Metric; Part Number GJM0335C1E1R5WB01; LCSC C435397
C10, C11, C14: 100n; C_0201_0603Metric; Voltage Rating 6.3V; Tolerance 20%; LCSC Part # C284992
C12: 2.0p; C_0201_0603Metric; Part Number GJM0335C1E2R0WB01; LCSC C668326
C15: 0.3p; C_0201_0603Metric; LCSC C76927
D9: LTST-C171GKT; LED_0805_2012Metric; LCSC C913075
J8: MM8130-2600RA2; LCSC C167503
J10: 1mm; PinHeader_1x02_P1.00mm_Vertical; not fitted
L1: 4.7u; L_0603_1608Metric; LCSC C76799
L2: 2.7n; L_0201_0603Metric; Part Number GJM0335C1E1R5WB01; LCSC C7216765
L3, L4: 3.5n; L_0201_0603Metric; Part Number LQP03HQ3N5B02; LCSC C3911055
Q7: SMMBT3904LT1G; LCSC C84555
R5: 0; R_0201_0603Metric; Tolerance 5%; LCSC C100147
R6: 330m; R_1206_3216Metric_Pad1.30x1.75mm_HandSolder; Tolerance 1%; LCSC C2932844
R7: 1k; R_0201_0603Metric; Tolerance 5%; LCSC C131396
R10, R11: 0; R_0603_1608Metric_Pad0.98x0.95mm_HandSolder; Tolerance 5%; LCSC C177335
R39, R40: 4.7k; R_0402_1005Metric_Pad0.72x0.64mm_HandSolder; Tolerance 5%; LCSC C105870
R43: 100; R_0402_1005Metric_Pad0.72x0.64mm_HandSolder; Tolerance 1%; LCSC C82865
SW1: KMR211G LFS; SW_Push_1P1T_NO_CK_KMR2; LCSC C221675
TP1, TP2, TP3, TP4, TP5, TP6, TP7, TP9, TP10, TP11: 1.0mm; TestPoint_Pad_D1.0mm
U1: nRF54L15-QFAA-R; NRF54L15-QFAA-R
Y1: ECS-320-8-37B-CKY-TR; LCSC C2636238
Y5: SC-20S,32.768kHz,20PPM,9pF; LCSC C97603

Connections:
3V3: R6.1, TP2.1 (1_1); also elsewhere on the board
/Transmitter/BOOT_A: U1.24 (P0.01); also elsewhere on the board
/Transmitter/Piezoelectric/PWM+: R10.1, U1.6 (P1.05/AIN1/TAMPC); also elsewhere on the board
/Transmitter/Piezoelectric/PWM-: R11.1, U1.7 (P1.06/AIN2/TAMPC); also elsewhere on the board
/Transmitter/TX Microcontroller/ANT: J8.2 (OUT)
/Transmitter/TX Microcontroller/LED: Q7.1 (B), U1.20 (P2.09/TRACEDATA[2]/SPI.SDI/SDO)
/Transmitter/TX Microcontroller/RF: C15.1, J8.1 (IN), L4.2
/Transmitter/TX Microcontroller/SCL: R40.2, U1.37 (P1.09/TAMPC); also elsewhere on the board
/Transmitter/TX Microcontroller/SDA: R39.2, U1.38 (P1.10/TAMPC); also elsewhere on the board
/Transmitter/TX Microcontroller/SWDCLK: J10.1, TP9.1 (1_1), U1.26 (SWDCLK)
/Transmitter/TX Microcontroller/SWDIO: J10.2, TP10.1 (1_1), U1.25 (SWDIO)
/Transmitter/TX Microcontroller/~RESET: C8.1, R7.1, TP7.1 (1_1), U1.30 (~RESET)
/Transmitter/nRF_URXD_A: U1.18 (P2.07/TRACEDATA[0]/SWO/SPI.DCX); also elsewhere on the board
/Transmitter/nRF_UTXD_A: U1.19 (P2.08/TRACEDATA[1]/SPI.SDI/SDO); also elsewhere on the board
/Transmitter/nRF_~RESET_A: R7.2, SW1.2; also elsewhere on the board
GND: C1.2, C2.2, C3.2, C4.2, C5.2, C6.2, C8.2, C9.2, C10.2, C11.2, C12.2, C14.2, C15.2, J8.3 (GND), J8.4 (GND), J8.5 (GND), J8.6 (GND), Q7.2 (E), SW1.1, TP11.1 (1_1), U1.32 (VSS_PA), U1.44 (VSS), U1.49 (VSS), Y1.2 (GND), Y1.4 (GND); also elsewhere on the board
unnamed: C9.1, L2.2, L3.1
unnamed: C12.1, L3.2, L4.1
unnamed: D9.1 (K), R43.1
unnamed: Q7.3 (C), R43.2
unnamed: L2.1, U1.31 (ANT)
unnamed: L1.2, TP3.1 (1_1), U1.46 (DCC)
unnamed: C1.1, C4.1, C5.1, R5.1, TP4.1 (1_1), U1.33 (DECRF), U1.43 (DECA)
unnamed: C6.1, L1.1, R5.2, TP1.1 (1_1), U1.45 (DECD)
unnamed: U1.34 (XC1), Y1.3
unnamed: U1.35 (XC2), Y1.1
unnamed: U1.1 (P1.00/XL1), Y5.2
unnamed: U1.2 (P1.01/XL2), Y5.1
unnamed: R10.2, U1.5 (P1.04/AIN0/TAMPC)
unnamed: R11.2, U1.8 (P1.07/AIN3/TAMPC)
TX3V3: C2.1, C3.1, C10.1, C11.1, C14.1, D9.2 (A), R6.2, R39.1, R40.1, TP5.1 (1_1), TP6.1 (1_1), U1.10 (VDD), U1.22 (VDD), U1.36 (VDD), U1.47 (VDD), U1.48 (VDD); also elsewhere on the board

Notes on the sheet:
SEE DATASHEET FOR GND ROUTING
Resistor and test points for measuring current draw
Replace w/ FB if needed
~{RESET} pulled up internally

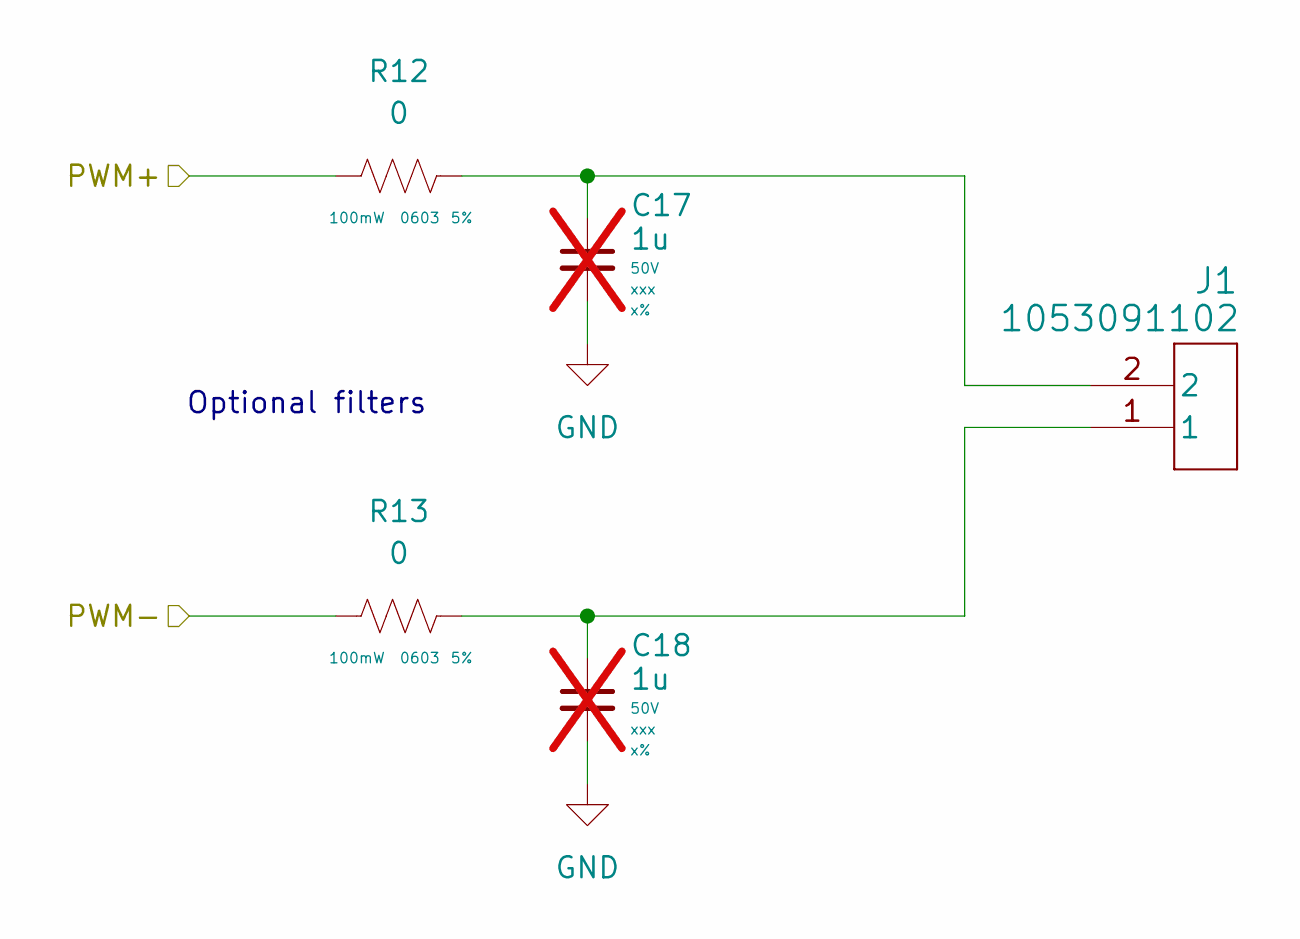
[picture p18: schematic piezo_TX.kicad_sch, Temperature Logger]

Parts:
C17, C18: 1u; C_0603_1608Metric_Pad1.08x0.95mm_HandSolder; Voltage Rating 50V; Tolerance x%; not fitted
J1: 1053091102; LCSC C2938824
R12, R13: 0; R_0603_1608Metric_Pad0.98x0.95mm_HandSolder; Tolerance 5%; LCSC C177335

Connections:
/Transmitter/Piezoelectric/PWM+: R12.1; also elsewhere on the board
/Transmitter/Piezoelectric/PWM-: R13.1; also elsewhere on the board
GND: C17.2, C18.2; also elsewhere on the board
unnamed: C17.1, J1.2, R12.2
unnamed: C18.1, J1.1, R13.2

Notes on the sheet:
Optional filters

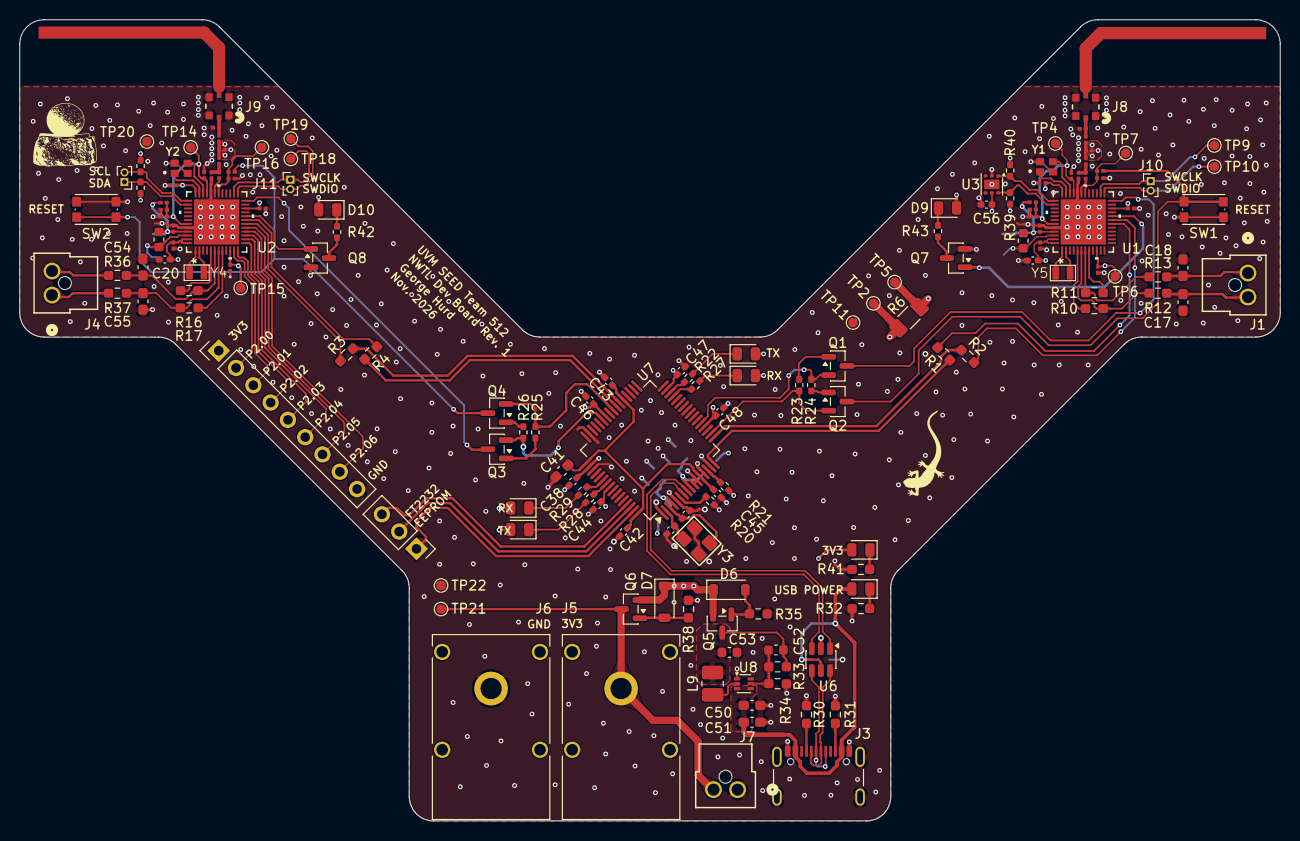
[picture p19: board Temp-Logger.kicad_pcb from above]

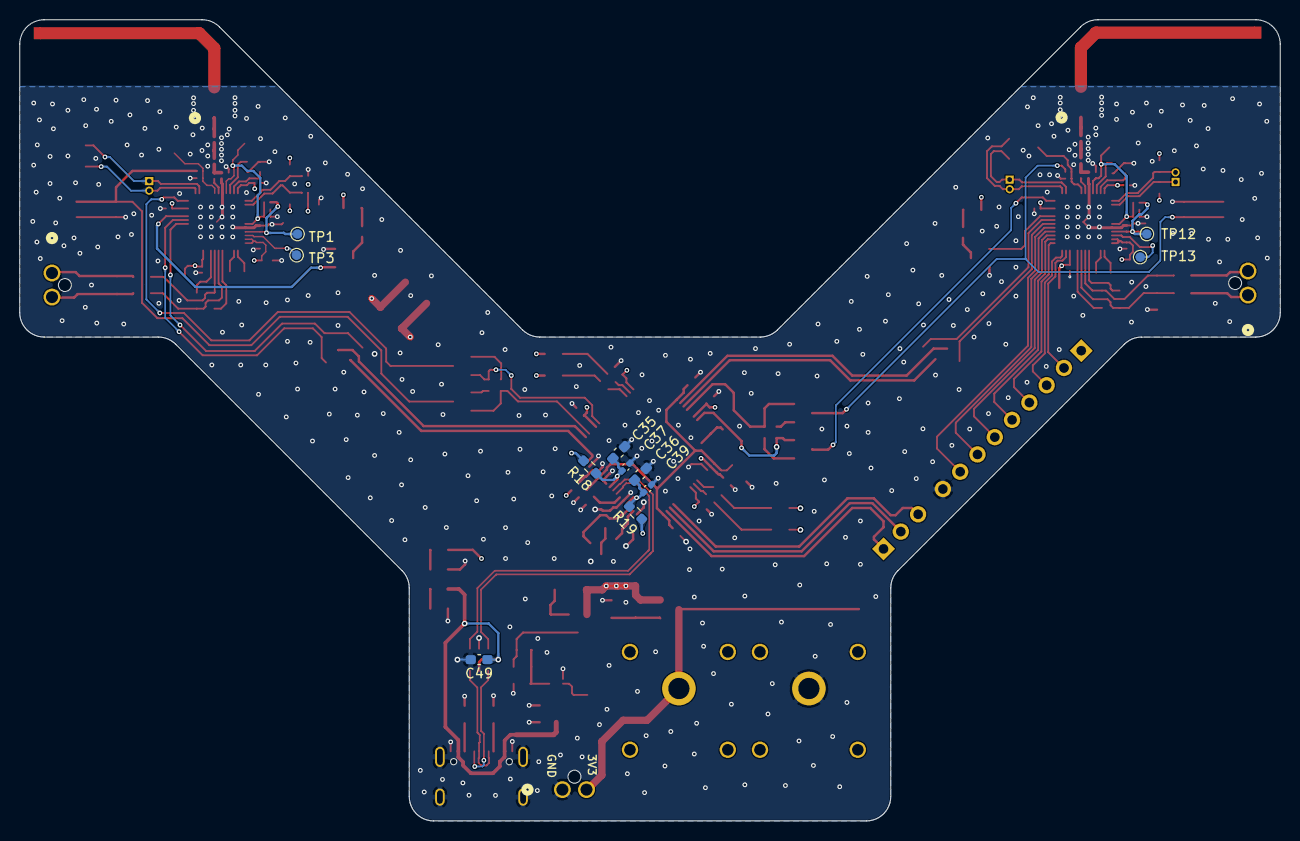
[picture p20: board Temp-Logger.kicad_pcb from below]

Board: 4 copper layers, 130.9 x 83.2 mm, 167 parts (11 on the bottom side), 113 nets.
