SEED-Team-512-NWTL/Temp-Logger/(commit log)

2026-10-15 Created KiCAD project files
    [Temp-Logger.kicad_pcb, Temp-Logger.kicad_sch]
2026-10-15 Added subsheet ports and a placeholder mcu
    [Temp-Logger.kicad_sch, microcontroller.kicad_sch, temp_sense.kicad_sch, transciever.kicad_sch]
2026-10-26 Created new hierarchy, added new nRF MCU, started really digging into schematic
    [Temp-Logger.kicad_sch, microcontroller.kicad_sch, piezo.kicad_sch, receiver.kicad_sch, rx_microcontroller.kicad_sch, transmitter.kicad_sch, tx_microcontroller.kicad_sch, usb.kicad_sch]
2026-10-27 Added USB to UART circuitry, cleaned up top sheets, added more supporting circuitry for TX MCU
    [FT2232.kicad_sch, Temp-Logger.kicad_sch, USB-C_connector.kicad_sch, rx_microcontroller.kicad_sch, temp_sense.kicad_sch, transmitter.kicad_sch, tx_microcontroller.kicad_sch, usb.kicad_sch]
2026-10-29 Finished schematic, added power section for external power (both power supply and battery), added current sensing for TX microcontroller
    [FT2232.kicad_sch, Power.kicad_sch, Temp-Logger.kicad_sch, USB-C_connector.kicad_sch, piezo.kicad_sch, piezo_RX.kicad_sch, piezo_TX.kicad_sch, receiver.kicad_sch]
2026-10-29 Removed old sheets from project
    [piezo.kicad_sch, transciever.kicad_sch]
2026-10-30 Made most capacitors 0402 for mcu sheets, defined board shape and started layout
    [FT2232.kicad_sch, Power.kicad_sch, Temp-Logger.kicad_pcb, Temp-Logger.kicad_sch, USB-C_connector.kicad_sch, piezo_RX.kicad_sch, piezo_TX.kicad_sch, rx_microcontroller.kicad_sch]
2026-11-06 Changed a bunch of footprints to be smaller, continued layout.
    [FT2232.kicad_sch, Temp-Logger.kicad_pcb, USB-C_connector.kicad_sch, piezo_RX.kicad_sch, piezo_TX.kicad_sch, rx_microcontroller.kicad_sch, temp_sense.kicad_sch, tx_microcontroller.kicad_sch]
2026-11-09 Major changes
    Minor schematic changes (added LEDs and antenna connector), finished placement and routing, fixed/added silkscreen, adjusted stackup. Need to fix DRC errors
    [FT2232.kicad_sch, Power.kicad_sch, Temp-Logger.kicad_pcb, rx_microcontroller.kicad_sch, tx_microcontroller.kicad_sch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]
2026-11-09 Fixed drc errors and made minor layout changes
    [Temp-Logger.kicad_pcb]
2026-11-11 Some minor routing changes, added header for port 2 on RX, added LCSC part numbers to most components
    [FT2232.kicad_sch, NWTL_Dev_Board_Rev_1_bom.csv, NWTL_Dev_Board_Rev_1_designators.csv, NWTL_Dev_Board_Rev_1_positions.csv, Power.kicad_sch, Team_512_Dev_Board_Rev_1_BOM.csv, Temp-Logger.kicad_pcb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]
2026-11-11 Finished matching components and exported BOM and gerbers
    [FT2232.kicad_sch, NWTL_Dev_Board_Rev_1_bom.csv, NWTL_Dev_Board_Rev_1_designators.csv, NWTL_Dev_Board_Rev_1_positions.csv, Power.kicad_sch, Temp-Logger.kicad_pcb, USB-C_connector.kicad_sch, rx_microcontroller.kicad_sch]
